AlphaCassiopeiae/8800/rs/README.md

# αCass 8800 Software
## Firmware
* `cycle`: emulated CPU card
* `recall`: emulated memory card
* `interchange`: emulated front panel device
* `ubahn`: emulated UART I/O card (not active)
* `tramtest`: minimal tram testing/debugging 
## Libraries
* `common`: utilities
* `runner`: CPU emulation core
* `tram`: low-level bus interface
