AlphaCassiopeiae/8800/docs/poster2.pdf

CPU

GND

SWDIO

SWCLK

GND

USBD-

USBD+

3V3

VBUS

SS

SD
4:0

SCLK

XIN

XOUT

~RESET

15:0
7:0

RP2350B...

ABM8-272-T3...

Chip Reset Ci...

W25Q128JVS... | SWD Debug Port

USB-C Debug P...

USB Debug Reg...

DDR4 DIMM Edge Connector ³V³ GND CLOCK PRESET PANEL PROT SM¹ SHLTA SSTACK | PHOLD | PDBIN | SWO | PWAIT | PRDY
SOUT
SINP

XRDY

MWRT

SMEMR
PINT

SINTA

PINTE
ADDR
DATA

Front Panel

Molex 5017868090 FFC Receptacle

RP2350B...

7:0

15:0

CLOCK

PRESET

PANEL
PROT
SM1

SHLTA
SSTACK

PHOLD
PDBIN

SWO

PWAIT

PRDY

SOUT
SINP

XRDY

MWRT
SMEMR

PINT

SINTA
PINTE
ADDR

GND

DATA
3V3

LED Array

D7 D6 D5 D4 D3 D2 D1 D0

A15 A14 A13 A12 A11 A10 A9 A8 A7 A6 A5 A4 A3 A2 A1 A0

DATA07 | DATA06 | DATA05 | DATA04 | DATA03 | DATA02 | DATA01 | DATA00
ADDR15 | ADDR14 | ADDR13 | ADDR12 | ADDR11 | ADDR10 | ADDR09 | ADDR08 | ADDR07 | ADDR06 | ADDR05 | ADDR04 | ADDR03 | ADDR02 | ADDR01 | ADDR00
INTE
PROT
MEMR
INP
M1
OUT
HLTA
STACK
WO
INT
WAIT
HLDA

TLC59211IPWR

TLC59211IPWR

Current Driven

TLC59211IPWR
GND

3V3

GND

3V3

GND

3V3

Power...

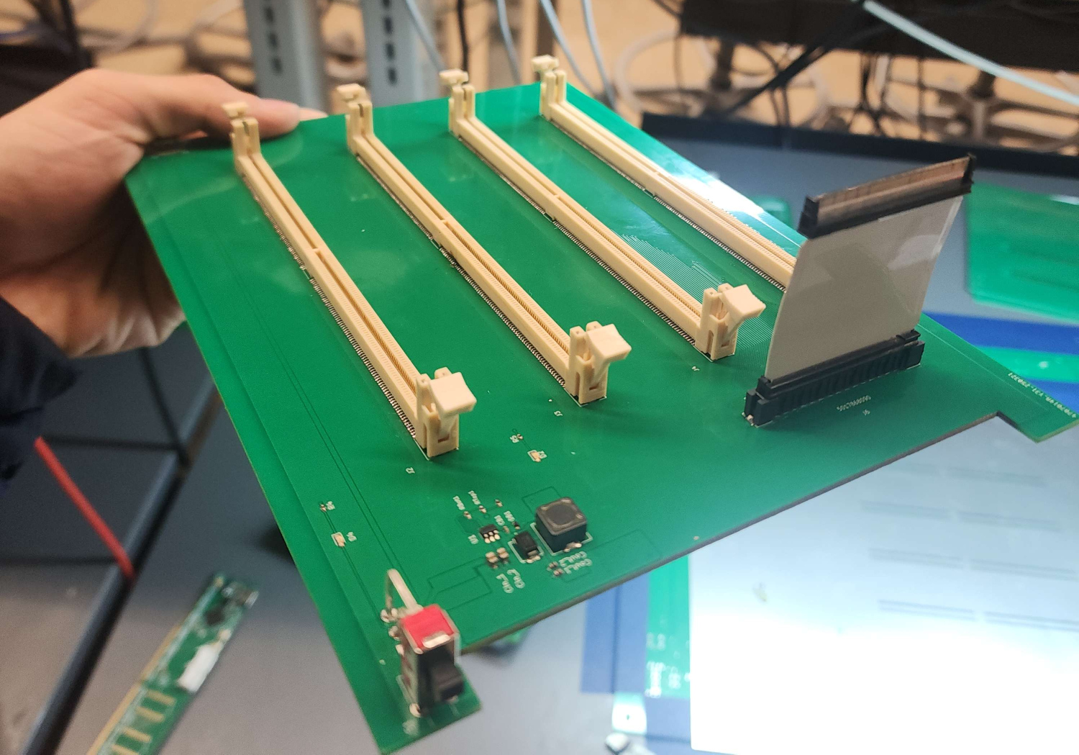
[picture p8: figure]

SS

SD
4:0

SCLK

XIN

XOUT

ABM8-272-T3...

Chip Reset Ci...

W25Q128JVS...

GND

SWDIO

SWCLK
SWD Debug Port

GND

USBD-

USBD+

3V3

VBUS

USB-C Debug P...

USB Debug Reg...

MCP23017 I2C...

MCP23017 I2C...

~RESET

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
Switch/Button Array

SW15 | SW14 | SW13 | SW12 | SW11 | SW10 | SW09 | SW08
SW07 | SW06 | SW05 | SW04 | SW03 | SW02 | SW01 | SW00
AUX2 | AUX1 UPROT PROT | CLR
RESET DEPN | DEP | EXMN | EXM | SS | RUN | STOP
GPB7 | GPB6 | GPB5 | GPB4 | GPB3 | GPB2 | GPB1 | GPB0
GPA7 | GPA6 | GPA5 | GPA4 | GPA3 | GPA2 | GPA1 | GPA0
GPB4 | GPB3 | GPB2 | GPB1 | GPB0
GPA7 | GPA6 | GPA5 | GPA4 | GPA3 | GPA2 | GPA1 | GPA0

DDR4 DIMM Slot Receptacle

Backplane

RAM

GND

SWDIO

SWCLK

GND

USBD-

USBD+

3V3

VBUS

SS

SD
4:0

SCLK

XIN

XOUT

~RESET

15:0
7:0

RP2350B...

ABM8-272-T3...

Chip Reset Ci...

W25Q128JVS... | SWD Debug Port

USB-C Debug P...

USB Debug Reg...

DDR4 DIMM Edge Connector ³V³ GND CLOCK PRESET PANEL PROT SM¹ SHLTA SSTACK | PHOLD | PDBIN | SWO | PWAIT | PRDY
SOUT
SINP

XRDY

MWRT

SMEMR
PINT

SINTA

PINTE
ADDR
DATA

Backplane

Molex 5017868090 FFC Receptacle

Voltage Re... USB-C...

DDR4 DIMM Slot Receptacle | VBUS
3V3

80-conductor 0.5mm Pitch FFC Cable

# BLOCK DIAGRAM

Legend

Card PCB

Backplane P...

Front Panel...

UI Element

# BUS DESIGN

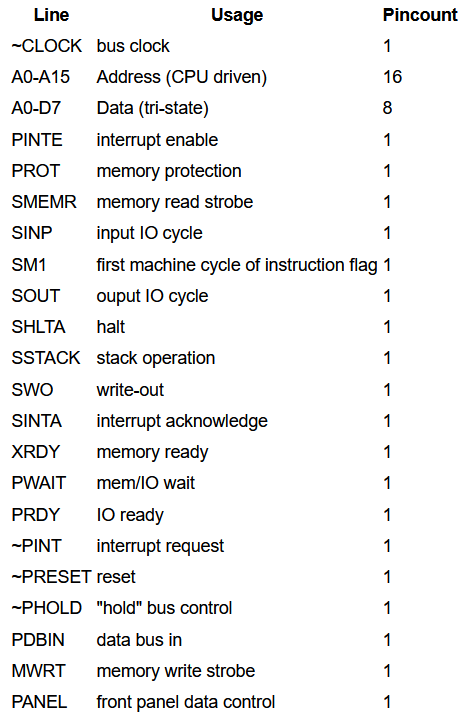
[picture p9: figure]

# EMULATION

# COMPONENTS

# PANEL

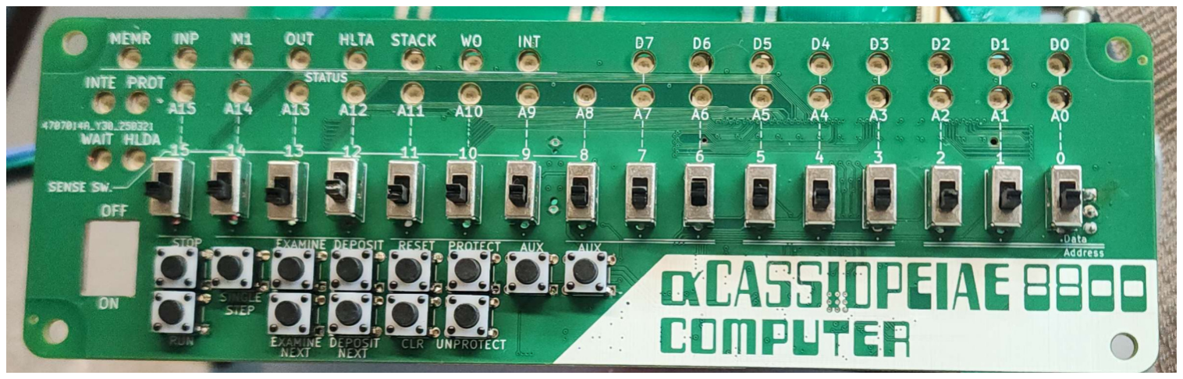
[picture p10: figure]

# CARDS

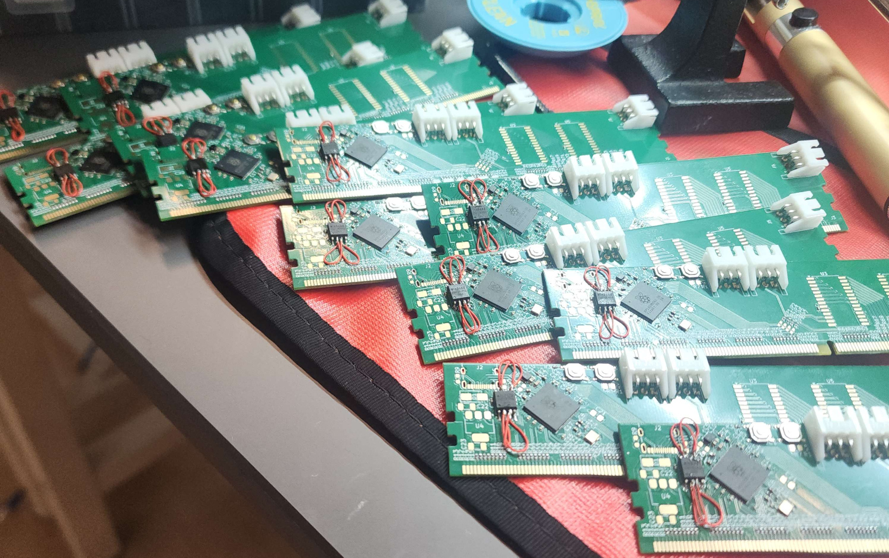
[picture p11: figure]

# BACKPLANE

At the heart of the αCassiopeiae 8800 lies sophisticated software enabling its functionality. A key component is the custom-built Intel 8080 CPU emulator, developed in Rust. This emulator achieves high fidelity, accurately decoding and executing 254 out of the 256 official 8080 opcodes. It meticulously replicates the 8080's machine cycles, including managing cycle timing, interrupt handling, and respecting I/O wait states, crucial for authentic operation. Complementing the emulator are low-level routines leveraging the Raspberry Pi RP2350B's powerful Programmable I/O (PIO) feature. Written in PIO assembly, these routines manage the intricate data exchange across the system's parallel bus. They orchestrate the complex transactions required for communication between the emulated CPU, the RAM card, and the interactive Front Panel, ensuring correct multi-device access and control over the shared bus lines for memory reads/writes, I/O operations, and front panel interactions.
