AlphaCassiopeiae/8800/docs/panel_pins.md

| Pin | Old | New | RP2350 | Driver |
|---|---|---|---|---|
| BUS03 | ~~???~~ | A3 | GPIO35 | U5 9 |
| BUS04 | ~~???~~ | D3 | GPIO34 | U5 8 |
| BUS05 | ~~???~~ | A2 | GPIO33 | U5 7 |
| BUS06 | ~~???~~ | D2 | GPIO32 | U5 6 |
| BUS09 | ~~???~~ | A0 | GPIO31 | U5 5 |
| BUS10 | ~~???~~ | A1 | GPIO41 | U5 4 |
| BUS11 | ~~???~~ | D1 | GPIO30 | U5 3 |
| BUS12 | ~~???~~ | D0 | GPIO40 | U5 2 |
| BUS15 | ~~???~~ | | | |
| BUS16 | ~~A0~~ | | | |
| BUS17 | ~~A1~~ | | | |
| BUS18 | ~~A2~~ | | | |
| BUS21 | ~~A3~~ | PANEL  | GPIO29 | |
| BUS22 | ~~A4~~ | MWRT | GPIO46 | |
| BUS23 | ~~A5~~ | DBIN | GPIO47 | |
| BUS24 | ~~A6~~ | HOLD | GPIO28 | |
| BUS27 | ~~A7~~ | RESET  | GPIO27 | |
| BUS28 | ~~D0~~ | PRDY | GPIO26 | |
| BUS29 | ~~D1~~ | XRDY | GPIO25 | |
| BUS30 | ~~D2~~ | INTA | GPIO24 | |
| BUS33 | ~~D3~~ | D7 | GPIO23 | U4 9 |
| BUS34 | ~~D4~~ | D6 | GPIO21 | U4 8 |
| BUS35 | ~~D5~~ | A6 | GPIO22 | U4 7 |
| BUS36 | ~~D6~~ | A7 | GPIO20 | U4 6 |
| BUS44 | ~~A8~~ | D5 | GPIO19 | U4 5 |
| BUS45 | ~~A9~~ | A5 | GPIO18 | U4 4 |
| BUS46 | ~~A10~~ | D4 | GPIO17 | U4 3 |
| BUS47 | ~~A11~~ | A4 | GPIO16 | U4 2 |
| BUS50 | ~~A12~~ | PROT | GPIO15 | U1 6 |
| BUS51 | ~~A13~~ | INTE | GPIO14 | U1 7 |
| BUS52 | ~~A14~~ | WAIT | GPIO13 | U1 8 |
| BUS53 | ~~A15~~ | HLDA | GPIO11 | U1 9 |
| BUS56 | ~~INT~~ | A12 | GPIO12 | U2 2 |
| BUS57 | ~~WO~~ | A13 | GPIO10 | U2 3 |
| BUS58 | ~~STACK~~ | OUT | GPIO09 | U2 4 |
| BUS59 | ~~HLTA~~ | M1 | GPIO08 | U2 5 |
| BUS62 | ~~OUT~~ | A14 | GPIO07 | U2 6 |
| BUS63 | ~~M1~~ | MEMR | GPIO06 | U2 7 |
| BUS64 | ~~INP~~ | INP | GPIO05 | U2 8 |
| BUS65 | ~~MEMR~~ | A15 | GPIO04 | U2 9 |
| BUS68 | ~~HLDA~~ | HLTA | GPIO00 | U3 9 |
| BUS69 | ~~WAIT~~ | STACK  | GPIO01 | U3 8 |
| BUS70 | ~~PROT~~ | A11 | GPIO03 | U3 7 |
| BUS71 | ~~INTE~~ | WO | GPIO02 | U3 6 |
| BUS74 | ~~I2C1_SCK~~ | A10 | GPIO45 | U3 5 |
| BUS75 | ~~I2C1_SDA~~ | INT | GPIO44 | U3 4 |
| BUS76 | ~~I2C0_SCK~~ | A9 | GPIO43 | U3 3 |
| BUS77 | ~~I2C0_SDA~~ | A8 | GPIO42 | U3 2 |
