AlphaCassiopeiae/8800/ecad/panel/#Laser.dxf

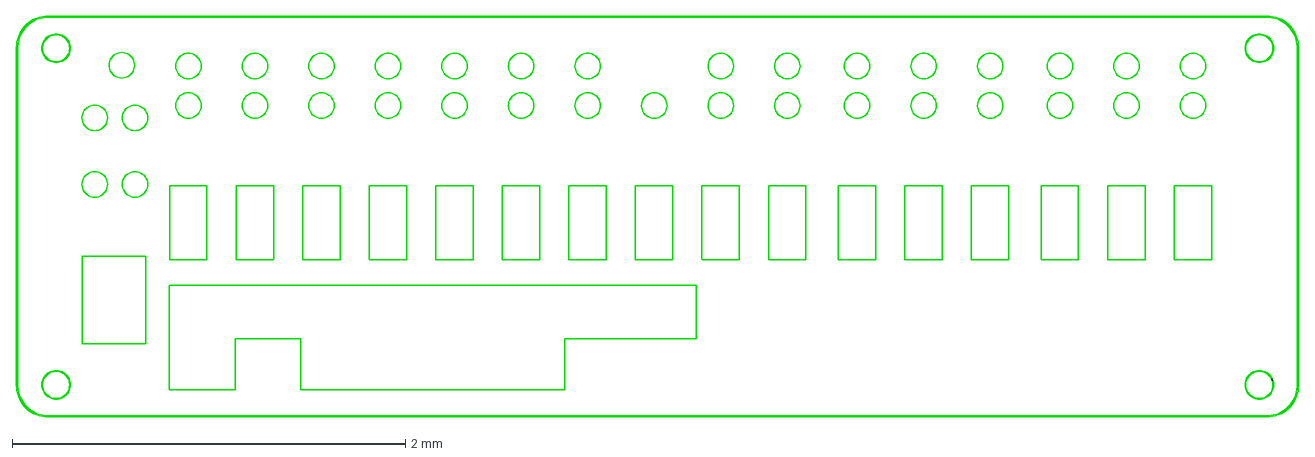
[picture p12: CAD file, 2025-04-22]
ecad/panel/#Laser.dxf
6.52 x 2.04 mm
