AlphaCassiopeiae/8800/mcad/Back Bezel Cutout.step

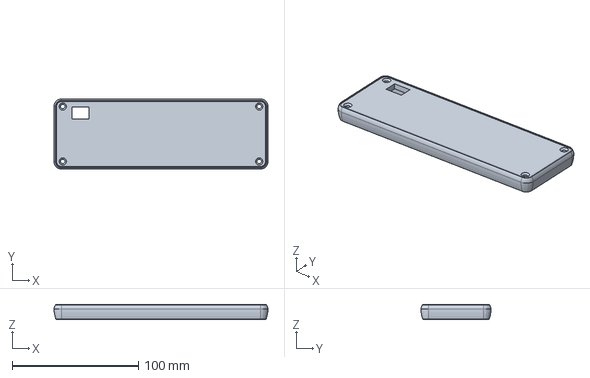
[picture p13: CAD file, 2025-04-30]
mcad/Back Bezel Cutout.step
169.5 x 55.6 x 11.5 mm
