AlphaCassiopeiae/8800/mcad/Front Bezel Cutout.step

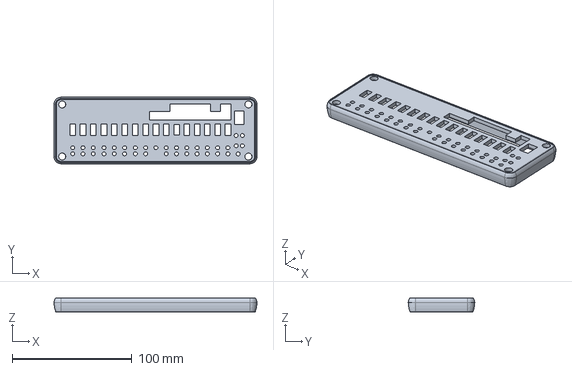
[picture p14: CAD file, 2025-04-30]
mcad/Front Bezel Cutout.step
169.5 x 55.6 x 11.5 mm
