AlphaCassiopeiae/8800/ecad/panel/panel-User_9.dxf

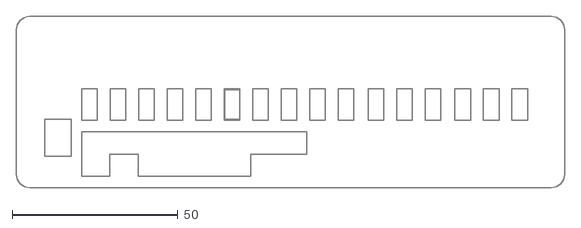
[picture p15: CAD file, 2025-04-22]
ecad/panel/panel-User_9.dxf
165.5 x 51.6
