AlphaCassiopeiae/8800/mcad/8800.FCStd

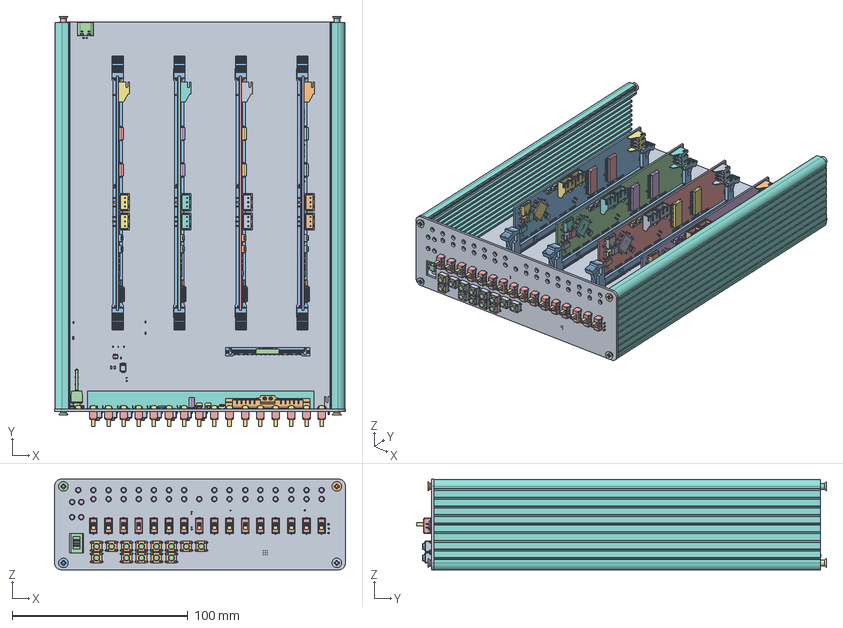
[picture p16: CAD file, 2025-04-30]
mcad/8800.FCStd
165.5 x 233.2 x 51.7 mm
Pcb_eb7f
OS102011MS2QN1 x 16
OS102011MS2QN002 x 16
OS102011MS2QN003 x 16
OS102011MS2QN004 x 16
OS102011MS2QN005 x 16
OS102011MS2QN006 x 16
R30_R_0402_1005Metric_0d118fe001ea x 90
AA3528-09 x 36
AA3528-010 x 36
AA3528-011 x 36
AA3528-012 x 36
AA3528-013 x 36
AA3528-014 x 36
D37_LED_0603_1608Metric_4a49271d0e42
U2_Texas_PWP0020A_8a7b458e77f9 x 5
LSM115JE3_TR13 x 3
LSM115JE3_TR014 x 3
LSM115JE3_TR015 x 3
LSM115JE3_TR016 x 3
C17_C_0402_1005Metric_134aba42bafa x 29
J2_JST_B3B_XH_A_700a59d3412c
5017868090wbm000_01
5017868090wbm000_002
U7_SOIC_8_5275x5275mm_P127mm_7bc3da358a65
U10_SOT_223_ac2cde4d368e
U9_QFN-28-1EP_6x6mm_Pitch0.65mm_3e3c0530614f x 2
Frame x 2
Cover x 2
Stem x 2
Terminal x 2
Terminal001 x 2
Terminal002 x 2
Terminal003 x 2
U6_rp2350text_0fa20b81210b
L1_AOTA-B201610S3R3-101-T_75ad346b99e7
T extrusion 220mm
1455 screw
1455 screw001
1455 screw002
1455 screw003
1455 screw004
1455 screw005
1455 screw006
1455 screw007
Pcb_b010
USB4105GFA_USB4105GFA
USB4105GFA_USB4105GFA001
USB4105GFA_USB4105GFA002
USB4105GFA_USB4105GFA003
USB4105GFA_USB4105GFA004
USB4105GFA_USB4105GFA005
USB4105GFA_USB4105GFA006
USB4105GFA_USB4105GFA007
USB4105GFA_USB4105GFA008
USB4105GFA_USB4105GFA009
USB4105GFA_USB4105GFA010
USB4105GFA_USB4105GFA011
USB4105GFA_USB4105GFA012
USB4105GFA_USB4105GFA013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
