AlphaCassiopeiae/8800/ecad/panel/Silkscreen.dxf

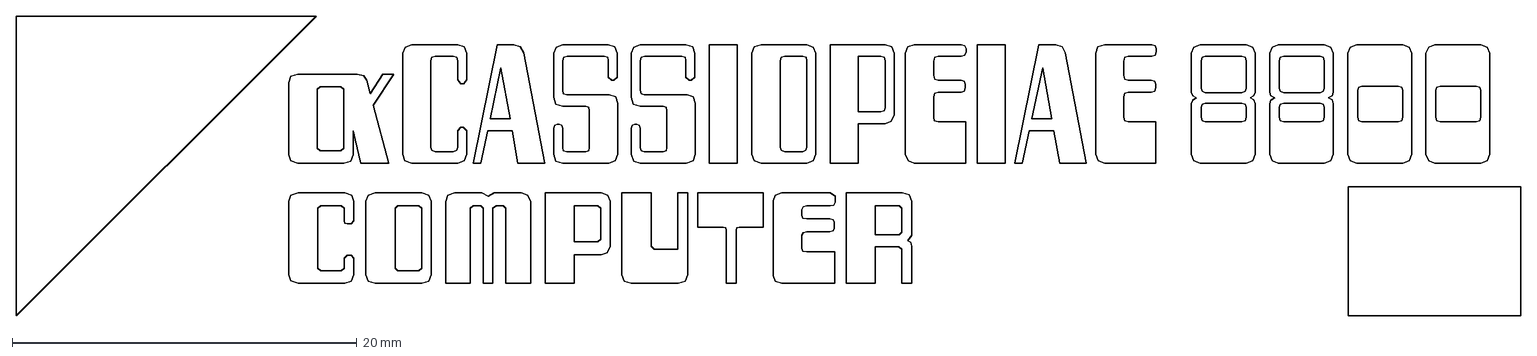
[picture p17: CAD file, 2025-03-16]
ecad/panel/Silkscreen.dxf
87.2 x 17.4 mm
