AlphaCassiopeiae/8800/mcad/Back Bezel.dxf

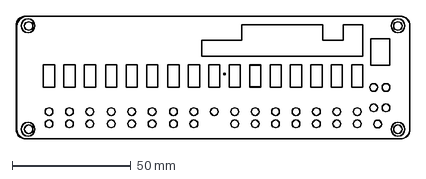
[picture p18: CAD file, 2025-04-22]
mcad/Back Bezel.dxf
165.5 x 51.7 mm
