AlphaCassiopeiae/8800/mcad/Laser_Cutout.FCStd

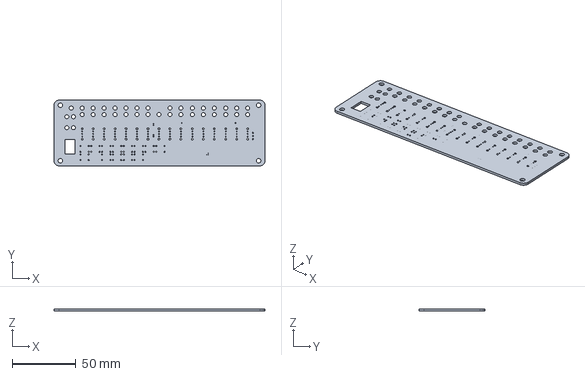
[picture p19: CAD file, 2025-04-22]
mcad/Laser_Cutout.FCStd
165.5 x 51.6 x 1.60 mm
