AlphaCassiopeiae/8800/mcad/Front Bezel.dxf

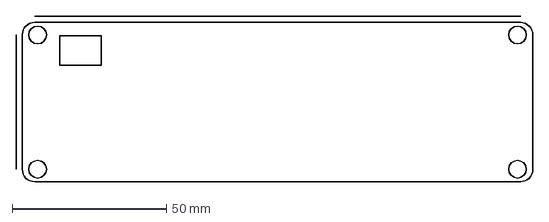
[picture p20: CAD file, 2025-04-22]
mcad/Front Bezel.dxf
167.5 x 53.6 mm
