AlphaCassiopeiae/8800/mcad/1455T2201.stp

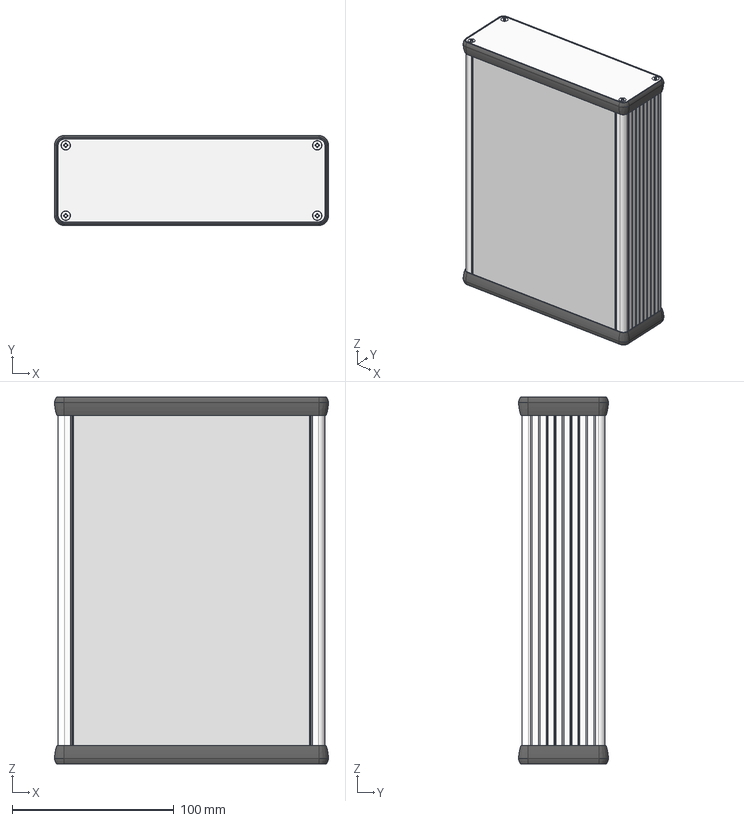
[picture p21: CAD file, 2025-03-12]
mcad/1455T2201.stp
169.5 x 55.6 x 227.0 mm
T extrusion 220mm
T Extrusion Cap 220mm
T Bezel Open x 2
T End Plate x 2
1455 screw x 8
