AlphaCassiopeiae/8800/(list of files, cad)

Other CAD files:
ecad/panel/Laser This.dxf
mcad/Black Bezel.dwg
mcad/Blue Bezel.dwg
ecad/panel/Laser.dxf
mcad/Back Bezel.f3d
mcad/Black Bezel Fusion.f3z
mcad/Blue Bezel Fusion.f3z
mcad/Front Bezel.f3d
