AlphaCassiopeiae/8800/ecad/panel/panel.kicad_pcb

## KiCad design ecad/panel/panel.kicad_pcb (2025-04-22)

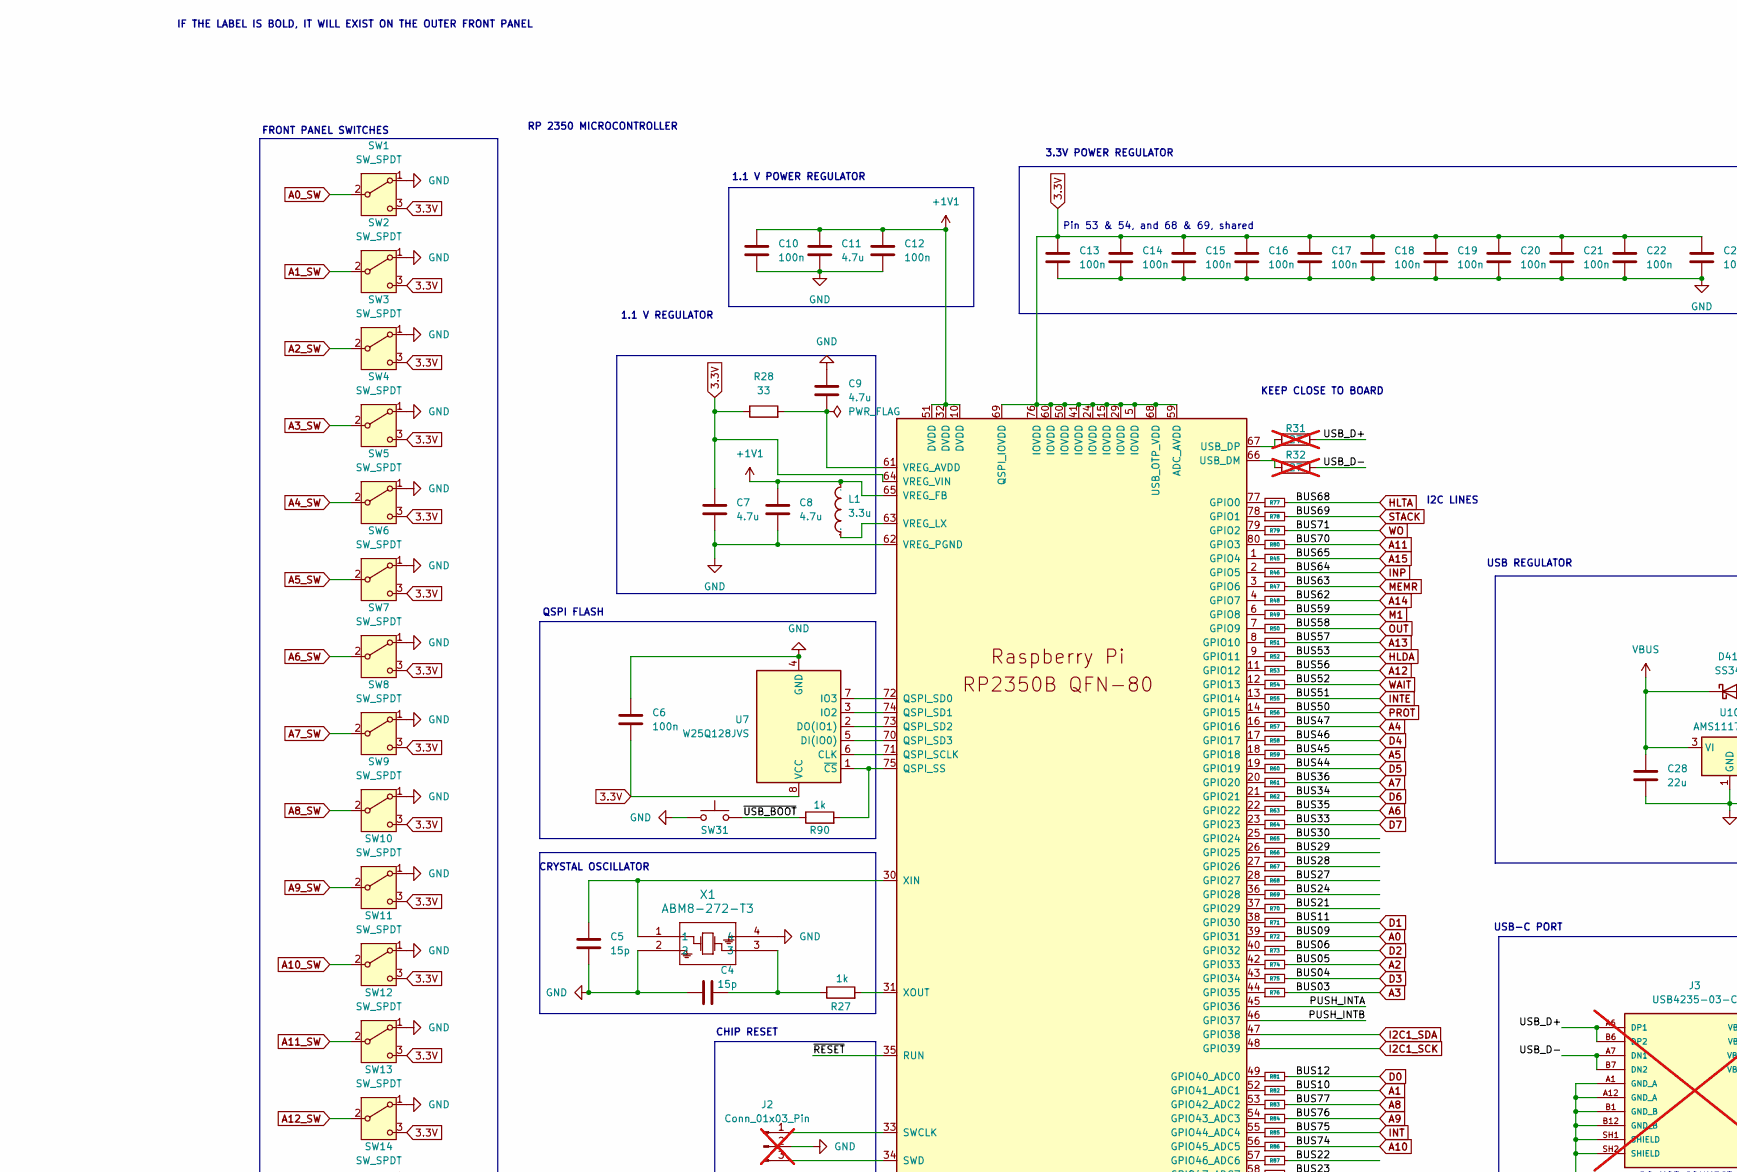
[picture p22: schematic panel.kicad_sch, Front Panel, part in row 1, column 2]

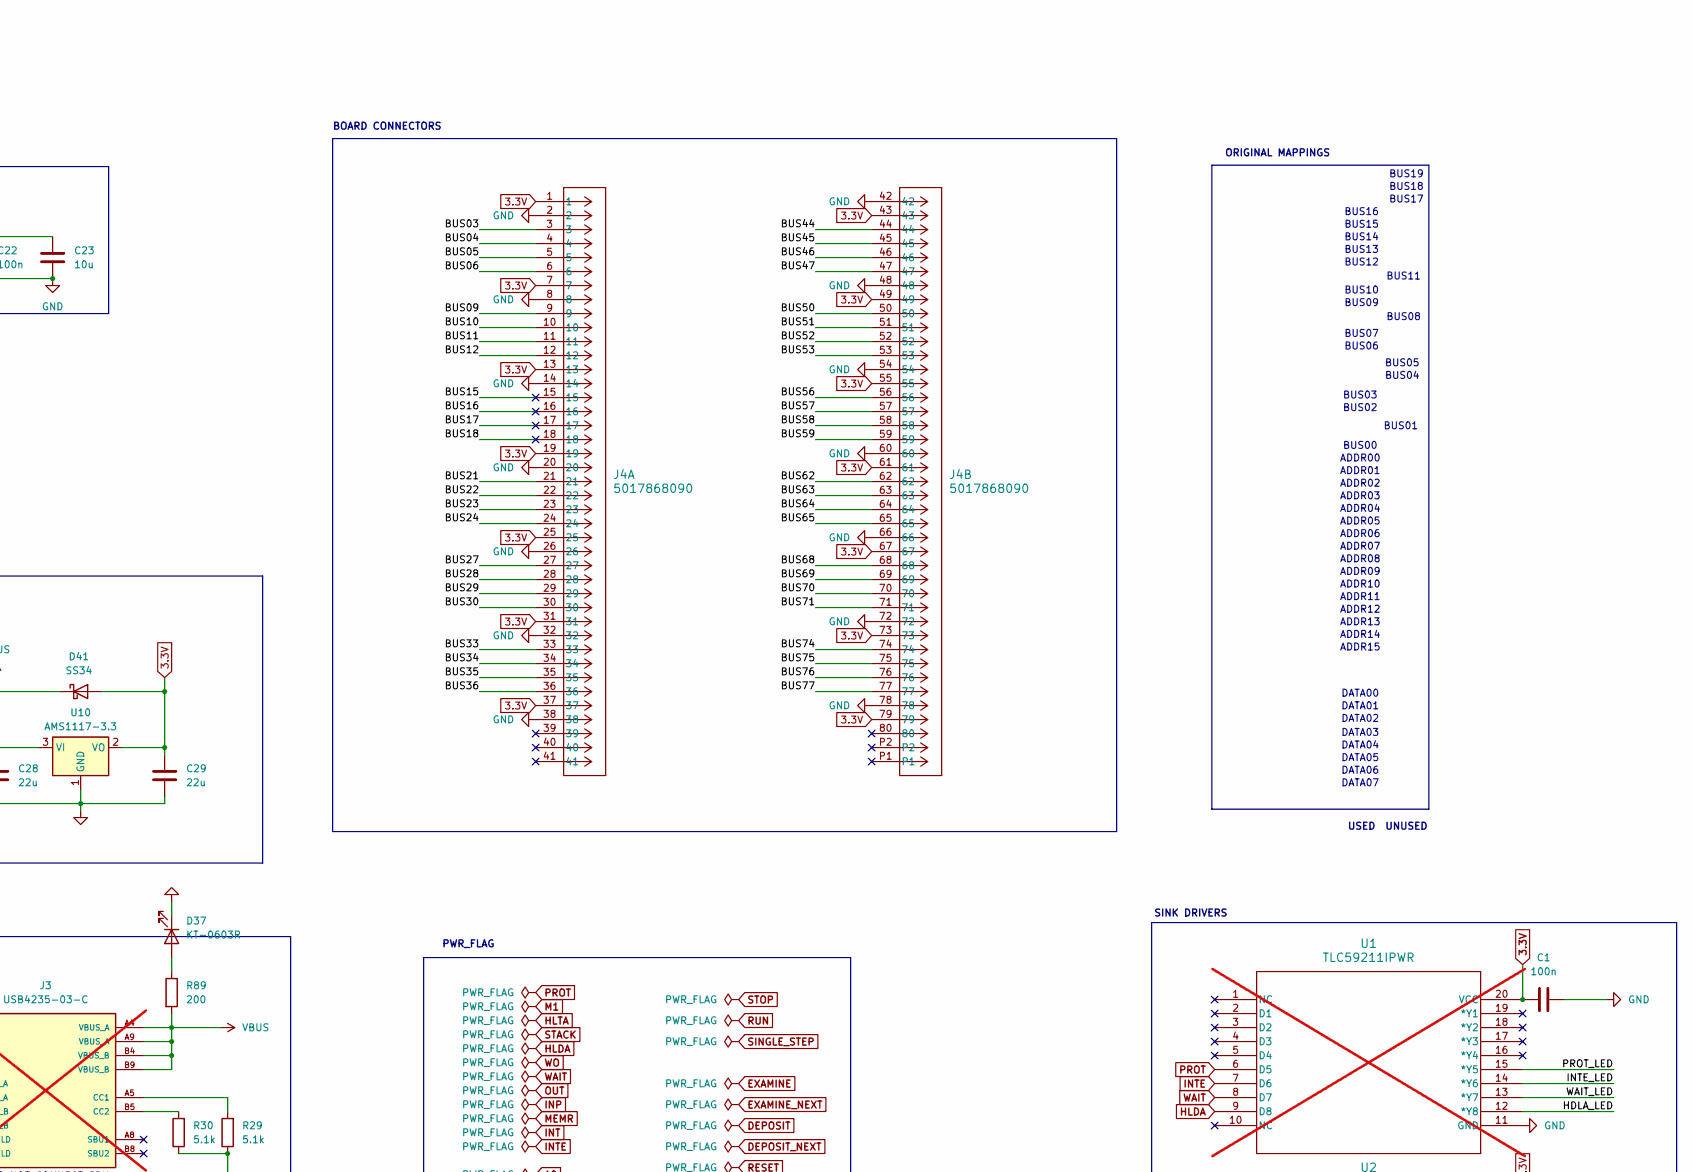
[picture p23: schematic panel.kicad_sch, Front Panel, part in row 1, column 3]

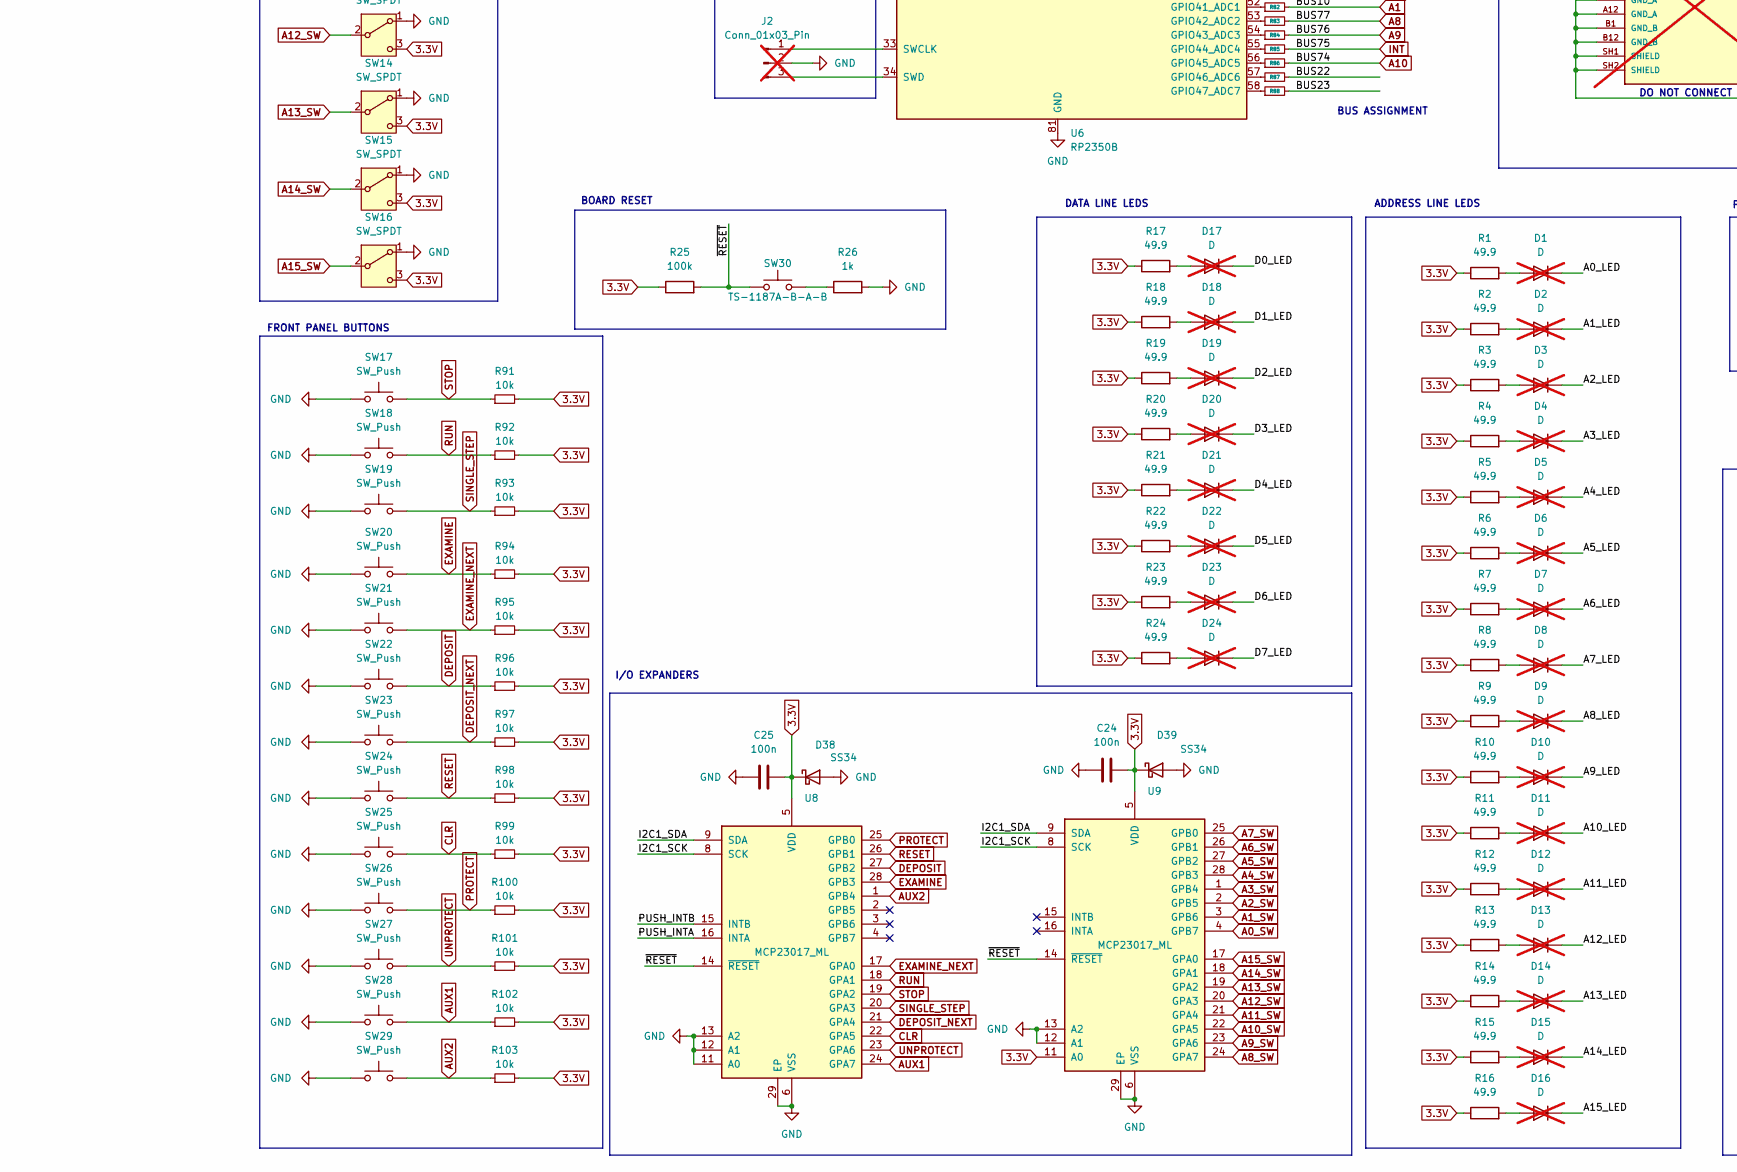
[picture p24: schematic panel.kicad_sch, Front Panel, part in row 2, column 2]

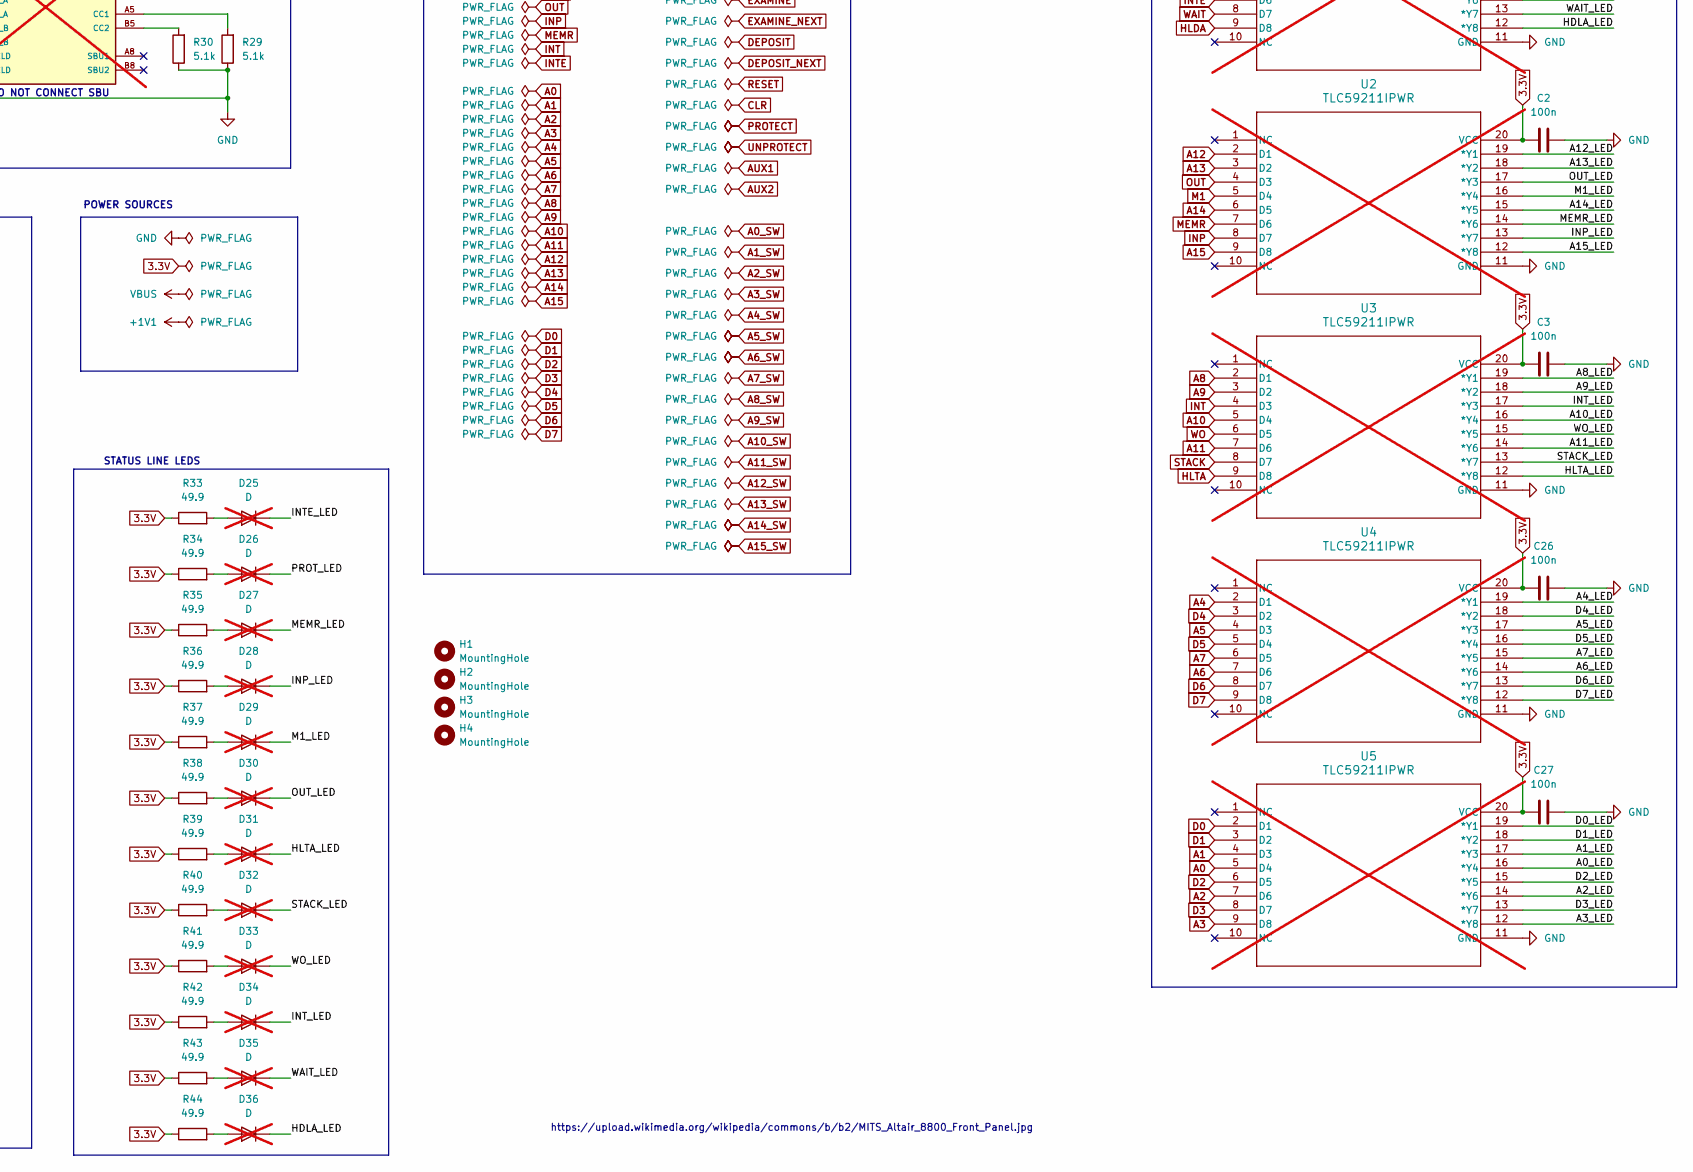
[picture p25: schematic panel.kicad_sch, Front Panel, part in row 2, column 3]

Parts:
C1, C2, C3, C6, C10, C12, C13, C14, C15, C16, C17, C18, C19, C20, C21, C22, C24, C25, C26, C27: 100n; C_0402_1005Metric
C4, C5: 15p; C_0402_1005Metric
C7, C8, C9, C11: 4.7u; C_0402_1005Metric
C23: 10u; C_0402_1005Metric
C28, C29: 22u; C_1206_3216Metric
D1, D2, D3, D4, D5, D6, D7, D8, D9, D10, D11, D12, D13, D14, D15, D16, D17, D18, D19, D20, D21, D22, D23, D24, D25, D26, D27, D28, D29, D30, D31, D32, D33, D34, D35, D36: D; AA3528SECKTJ309; not fitted
D37: KT-0603R; LED_0603_1608Metric_Pad1.05x0.95mm_HandSolder; LCSC Part # C2286
D38, D39, D41: SS34; D_SMA
H1, H2, H3, H4: MountingHole; MountingHole_3.5mm
J2: Conn_01x03_Pin; JST_XH_B3B-XH-A_1x03_P2.50mm_Vertical; not fitted
J3: USB4235-03-C; GCT_USB4235-03-C_REVA; PARTREV A; not fitted
J4: 5017868090; CON_5017868090
L1: 3.3u; IND-SMD_L2.0-W1.6_AOTA-B201610S3R3-101-T; Manufacturer Part AOTA-B201610S3R3-101-T; LCSC Part # C42411119
R1, R2, R3, R4, R5, R6, R7, R8, R9, R10, R11, R12, R13, R14, R15, R16, R17, R18, R19, R20, R21, R22, R23, R24, R33, R34, R35, R36, R37, R38, R39, R40, R41, R42, R43, R44: 49.9; R_0402_1005Metric_Pad0.72x0.64mm_HandSolder
R25: 100k; R_0402_1005Metric_Pad0.72x0.64mm_HandSolder
R26, R27, R90: 1k; R_0402_1005Metric_Pad0.72x0.64mm_HandSolder
R28: 33; R_0402_1005Metric_Pad0.72x0.64mm_HandSolder
R29, R30: 5.1k; R_0402_1005Metric_Pad0.72x0.64mm_HandSolder
R31, R32: 27; R_0603_1608Metric_Pad0.98x0.95mm_HandSolder; not fitted
R45, R46, R47, R48, R49, R50, R51, R52, R53, R54, R55, R56, R57, R58, R59, R60, R61, R62, R63, R64, R65, R66, R67, R68, R69, R70, R71, R72, R73, R74, R75, R76, R77, R78, R79, R80, R81, R82, R83, R84, R85, R86, R87, R88: 330; R_0402_1005Metric_Pad0.72x0.64mm_HandSolder
R89: 200; R_0402_1005Metric_Pad0.72x0.64mm_HandSolder
R91, R92, R93, R94, R95, R96, R97, R98, R99, R100, R101, R102, R103: 10k; C_0402_1005Metric
SW1, SW2, SW3, SW4, SW5, SW6, SW7, SW8, SW9, SW10, SW11, SW12, SW13, SW14, SW15, SW16: SW_SPDT; SW_OS102011MS2QN1
SW17, SW18, SW19, SW20, SW21, SW22, SW23, SW24, SW25, SW26, SW27, SW28, SW29: SW_Push; SW_1825910-6-4
SW30, SW31: TS-1187A-B-A-B; SW_Push_1P1T_XKB_TS-1187A
U1, U2, U3, U4, U5: TLC59211IPWR; Texas_PWP0020A; not fitted
U6: RP2350B; RP2350-QFN-80-1EP_10x10_P0.4mm_EP3.4x3.4mm_ThermalVias
U7: W25Q128JVS; SOIC-8_5.23x5.23mm_P1.27mm
U8, U9: MCP23017_ML; QFN-28-1EP_6x6mm_P0.65mm_EP4.25x4.25mm; LCSC Part # C639770
U10: AMS1117-3.3; SOT-223-3_TabPin2
X1: ABM8-272-T3; ABM8-272-T3_ABR

Connections:
3.3V: C1.1, C2.1, C3.1, C6.1, C7.1, C13.1, C14.1, C15.1, C16.1, C17.1, C18.1, C19.1, C20.1, C21.1, C22.1, C23.1, C24.2, C25.2, C26.1, C27.1, C29.1, D38.1 (K), D39.1 (K), D41.2 (A), J4.1, J4.7, J4.13, J4.19, J4.25, J4.31, J4.37, J4.43, J4.49, J4.55, J4.61, J4.67, J4.73, J4.79, R1.1, R2.1, R3.1, R4.1, R5.1, R6.1, R7.1, R8.1, R9.1, R10.1, R11.1, R12.1, R13.1, R14.1, R15.1, R16.1, R17.1, R18.1, R19.1, R20.1, R21.1, R22.1, R23.1, R24.1, R25.1, R28.1, R33.1, R34.1, R35.1, R36.1, R37.1, R38.1, R39.1, R40.1, R41.1, R42.1, R43.1, R44.1, R91.2, R92.2, R93.2, R94.2, R95.2, R96.2, R97.2, R98.2, R99.2, R100.2, R101.2, R102.2, R103.2, SW1.3 (C), SW2.3 (C), SW3.3 (C), SW4.3 (C), SW5.3 (C), SW6.3 (C), SW7.3 (C), SW8.3 (C), SW9.3 (C), SW10.3 (C), SW11.3 (C), SW12.3 (C), SW13.3 (C), SW14.3 (C), SW15.3 (C), SW16.3 (C), U1.20 (VCC), U2.20 (VCC), U3.20 (VCC), U4.20 (VCC), U5.20 (VCC), U6.5 (IOVDD), U6.15 (IOVDD), U6.24 (IOVDD), U6.29 (IOVDD), U6.41 (IOVDD), U6.50 (IOVDD), U6.59 (ADC_AVDD), U6.60 (IOVDD), U6.64 (VREG_VIN), U6.68 (USB_OTP_VDD), U6.69 (QSPI_IOVDD), U6.76 (IOVDD), U7.8 (VCC), U8.5 (VDD), U9.5 (VDD), U9.11 (A0), U10.2 (VO)
+1V1: C8.1, C10.1, C11.1, C12.1, L1.2, U6.10 (DVDD), U6.32 (DVDD), U6.51 (DVDD), U6.65 (VREG_FB)
/A0_LED: D1.1 (K), U5.16 (*Y4)
/A1_LED: D2.1 (K), U5.17 (*Y3)
/A2_LED: D3.1 (K), U5.14 (*Y6)
/A3_LED: D4.1 (K), U5.12 (*Y8)
/A4_LED: D5.1 (K), U4.19 (*Y1)
/A5_LED: D6.1 (K), U4.17 (*Y3)
/A6_LED: D7.1 (K), U4.14 (*Y6)
/A7_LED: D8.1 (K), U4.15 (*Y5)
/A8_LED: D9.1 (K), U3.19 (*Y1)
/A9_LED: D10.1 (K), U3.18 (*Y2)
/A10_LED: D11.1 (K), U3.16 (*Y4)
/A11_LED: D12.1 (K), U3.14 (*Y6)
/A12_LED: D13.1 (K), U2.19 (*Y1)
/A13_LED: D14.1 (K), U2.18 (*Y2)
/A14_LED: D15.1 (K), U2.15 (*Y5)
/A15_LED: D16.1 (K), U2.12 (*Y8)
/BUS15: J4.15
/BUS16: J4.16
/BUS17: J4.17
/BUS18: J4.18
/BUS21: J4.21, R70.2
/BUS22: J4.22, R87.2
/BUS23: J4.23, R88.2
/BUS24: J4.24, R69.2
/BUS27: J4.27, R68.2
/BUS28: J4.28, R67.2
/BUS29: J4.29, R66.2
/BUS30: J4.30, R65.2
/D0_LED: D17.1 (K), U5.19 (*Y1)
/D1_LED: D18.1 (K), U5.18 (*Y2)
/D2_LED: D19.1 (K), U5.15 (*Y5)
/D3_LED: D20.1 (K), U5.13 (*Y7)
/D4_LED: D21.1 (K), U4.18 (*Y2)
/D5_LED: D22.1 (K), U4.16 (*Y4)
/D6_LED: D23.1 (K), U4.13 (*Y7)
/D7_LED: D24.1 (K), U4.12 (*Y8)
/HDLA_LED: D36.1 (K), U1.12 (*Y8)
/HLTA_LED: D31.1 (K), U3.12 (*Y8)
/INP_LED: D28.1 (K), U2.13 (*Y7)
/INTE_LED: D25.1 (K), U1.14 (*Y6)
/INT_LED: D34.1 (K), U3.17 (*Y3)
/M1_LED: D29.1 (K), U2.16 (*Y4)
/MEMR_LED: D27.1 (K), U2.14 (*Y6)
/OUT_LED: D30.1 (K), U2.17 (*Y3)
/PROT_LED: D26.1 (K), U1.15 (*Y5)
/PUSH_INTA: U6.45 (GPIO36), U8.16 (INTA)
/PUSH_INTB: U6.46 (GPIO37), U8.15 (INTB)
/STACK_LED: D32.1 (K), U3.13 (*Y7)
/USB_D+: J3.A6 (DP1), J3.B6 (DP2), R31.2
/USB_D-: J3.A7 (DN1), J3.B7 (DN2), R32.2
/WAIT_LED: D35.1 (K), U1.13 (*Y7)
/WO_LED: D33.1 (K), U3.15 (*Y5)
/~RESET: R25.2, SW30.1, U6.35 (RUN), U8.14 (~RESET), U9.14 (~RESET)
/~USB_BOOT: R90.1, SW31.2
A0: J4.9, R72.2, U5.5 (D4)
A0_SW: SW1.2 (B), U9.4 (GPB7)
A1: J4.10, R82.2, U5.4 (D3)
A1_SW: SW2.2 (B), U9.3 (GPB6)
A2: J4.5, R74.2, U5.7 (D6)
A2_SW: SW3.2 (B), U9.2 (GPB5)
A3: J4.3, R76.2, U5.9 (D8)
A3_SW: SW4.2 (B), U9.1 (GPB4)
A4: J4.47, R57.2, U4.2 (D1)
A4_SW: SW5.2 (B), U9.28 (GPB3)
A5: J4.45, R59.2, U4.4 (D3)
A5_SW: SW6.2 (B), U9.27 (GPB2)
A6: J4.35, R63.2, U4.7 (D6)
A6_SW: SW7.2 (B), U9.26 (GPB1)
A7: J4.36, R61.2, U4.6 (D5)
A7_SW: SW8.2 (B), U9.25 (GPB0)
A8: J4.77, R83.2, U3.2 (D1)
A8_SW: SW9.2 (B), U9.24 (GPA7)
A9: J4.76, R84.2, U3.3 (D2)
A9_SW: SW10.2 (B), U9.23 (GPA6)
A10: J4.74, R86.2, U3.5 (D4)
A10_SW: SW11.2 (B), U9.22 (GPA5)
A11: J4.70, R80.2, U3.7 (D6)
A11_SW: SW12.2 (B), U9.21 (GPA4)
A12: J4.56, R53.2, U2.2 (D1)
A12_SW: SW13.2 (B), U9.20 (GPA3)
A13: J4.57, R51.2, U2.3 (D2)
A13_SW: SW14.2 (B), U9.19 (GPA2)
A14: J4.62, R48.2, U2.6 (D5)
A14_SW: SW15.2 (B), U9.18 (GPA1)
A15: J4.65, R45.2, U2.9 (D8)
A15_SW: SW16.2 (B), U9.17 (GPA0)
AUX1: R102.1, SW28.2, U8.24 (GPA7)
AUX2: R103.1, SW29.2, U8.1 (GPB4)
CLR: R99.1, SW25.2, U8.22 (GPA5)
D0: J4.12, R81.2, U5.2 (D1)
D1: J4.11, R71.2, U5.3 (D2)
D2: J4.6, R73.2, U5.6 (D5)
D3: J4.4, R75.2, U5.8 (D7)
D4: J4.46, R58.2, U4.3 (D2)
D5: J4.44, R60.2, U4.5 (D4)
D6: J4.34, R62.2, U4.8 (D7)
D7: J4.33, R64.2, U4.9 (D8)
DEPOSIT: R96.1, SW22.2, U8.27 (GPB2)
DEPOSIT_NEXT: R97.1, SW23.2, U8.21 (GPA4)
EXAMINE: R94.1, SW20.2, U8.28 (GPB3)
EXAMINE_NEXT: R95.1, SW21.2, U8.17 (GPA0)
GND: C1.2, C2.2, C3.2, C4.2, C5.2, C6.2, C7.2, C8.2, C9.1, C10.2, C11.2, C12.2, C13.2, C14.2, C15.2, C16.2, C17.2, C18.2, C19.2, C20.2, C21.2, C22.2, C23.2, C24.1, C25.1, C26.2, C27.2, C28.2, C29.2, D37.1 (K), D38.2 (A), D39.2 (A), J2.2, J3.A1 (GND_A), J3.A12 (GND_A), J3.B1 (GND_B), J3.B12 (GND_B), J3.SH1 (SHIELD), J3.SH2 (SHIELD), J4.2, J4.8, J4.14, J4.20, J4.26, J4.32, J4.38, J4.42, J4.48, J4.54, J4.60, J4.66, J4.72, J4.78, R26.2, R29.1, R30.1, SW1.1 (A), SW2.1 (A), SW3.1 (A), SW4.1 (A), SW5.1 (A), SW6.1 (A), SW7.1 (A), SW8.1 (A), SW9.1 (A), SW10.1 (A), SW11.1 (A), SW12.1 (A), SW13.1 (A), SW14.1 (A), SW15.1 (A), SW16.1 (A), SW17.1, SW18.1, SW19.1, SW20.1, SW21.1, SW22.1, SW23.1, SW24.1, SW25.1, SW26.1, SW27.1, SW28.1, SW29.1, SW31.1, U1.11 (GND), U2.11 (GND), U3.11 (GND), U4.11 (GND), U5.11 (GND), U6.62 (VREG_PGND), U6.81 (GND), U7.4 (GND), U8.6 (VSS), U8.11 (A0), U8.12 (A1), U8.13 (A2), U8.29 (EP), U9.6 (VSS), U9.12 (A1), U9.13 (A2), U9.29 (EP), U10.1 (GND), X1.2, X1.4
HLDA: J4.53, R52.2, U1.9 (D8)
HLTA: J4.68, R77.2, U3.9 (D8)
I2C1_SCK: U6.48 (GPIO39), U8.8 (SCK), U9.8 (SCK)
I2C1_SDA: U6.47 (GPIO38), U8.9 (SDA), U9.9 (SDA)
INP: J4.64, R46.2, U2.8 (D7)
INT: J4.75, R85.2, U3.4 (D3)
INTE: J4.51, R55.2, U1.7 (D6)
M1: J4.59, R49.2, U2.5 (D4)
MEMR: J4.63, R47.2, U2.7 (D6)
unnamed: C4.1, R27.1, X1.3
unnamed: D1.2 (A), R1.2
unnamed: D2.2 (A), R2.2
unnamed: D3.2 (A), R3.2
unnamed: D4.2 (A), R4.2
unnamed: D5.2 (A), R5.2
unnamed: D6.2 (A), R6.2
unnamed: D7.2 (A), R7.2
unnamed: D8.2 (A), R8.2
unnamed: D9.2 (A), R9.2
unnamed: D10.2 (A), R10.2
unnamed: D11.2 (A), R11.2
unnamed: D12.2 (A), R12.2
unnamed: D13.2 (A), R13.2
unnamed: D14.2 (A), R14.2
unnamed: D15.2 (A), R15.2
unnamed: D16.2 (A), R16.2
unnamed: D17.2 (A), R17.2
unnamed: D18.2 (A), R18.2
unnamed: D19.2 (A), R19.2
unnamed: D20.2 (A), R20.2
unnamed: D21.2 (A), R21.2
unnamed: D22.2 (A), R22.2
unnamed: D23.2 (A), R23.2
unnamed: D24.2 (A), R24.2
unnamed: D25.2 (A), R33.2
unnamed: D26.2 (A), R34.2
unnamed: D27.2 (A), R35.2
unnamed: D28.2 (A), R36.2
unnamed: D29.2 (A), R37.2
unnamed: D30.2 (A), R38.2
unnamed: D31.2 (A), R39.2
unnamed: D32.2 (A), R40.2
unnamed: D33.2 (A), R41.2
unnamed: D34.2 (A), R42.2
unnamed: D35.2 (A), R43.2
unnamed: D36.2 (A), R44.2
unnamed: D37.2 (A), R89.1
unnamed: J2.1, U6.33 (SWCLK)
unnamed: J2.3, U6.34 (SWD)
unnamed: J3.A5 (CC1), R29.2
unnamed: J3.B5 (CC2), R30.2
unnamed: R26.1, SW30.2
unnamed: R77.1, U6.77 (GPIO0)
unnamed: R78.1, U6.78 (GPIO1)
unnamed: R79.1, U6.79 (GPIO2)
unnamed: R80.1, U6.80 (GPIO3)
unnamed: R45.1, U6.1 (GPIO4)
unnamed: R46.1, U6.2 (GPIO5)
unnamed: R47.1, U6.3 (GPIO6)
unnamed: R48.1, U6.4 (GPIO7)
unnamed: R49.1, U6.6 (GPIO8)
unnamed: R50.1, U6.7 (GPIO9)
unnamed: R51.1, U6.8 (GPIO10)
unnamed: R52.1, U6.9 (GPIO11)
unnamed: R53.1, U6.11 (GPIO12)
unnamed: R54.1, U6.12 (GPIO13)
unnamed: R55.1, U6.13 (GPIO14)
unnamed: R56.1, U6.14 (GPIO15)
unnamed: R57.1, U6.16 (GPIO16)
unnamed: R58.1, U6.17 (GPIO17)
unnamed: R59.1, U6.18 (GPIO18)
unnamed: R60.1, U6.19 (GPIO19)
unnamed: R61.1, U6.20 (GPIO20)
unnamed: R62.1, U6.21 (GPIO21)
unnamed: R63.1, U6.22 (GPIO22)
unnamed: R64.1, U6.23 (GPIO23)
unnamed: R65.1, U6.25 (GPIO24)
unnamed: R66.1, U6.26 (GPIO25)
unnamed: R67.1, U6.27 (GPIO26)
unnamed: R68.1, U6.28 (GPIO27)
unnamed: R69.1, U6.36 (GPIO28)
unnamed: R70.1, U6.37 (GPIO29)
unnamed: R71.1, U6.38 (GPIO30)
unnamed: R72.1, U6.39 (GPIO31)
unnamed: R73.1, U6.40 (GPIO32)
unnamed: R74.1, U6.42 (GPIO33)
unnamed: R75.1, U6.43 (GPIO34)
unnamed: R76.1, U6.44 (GPIO35)
unnamed: R81.1, U6.49 (GPIO40_ADC0)
unnamed: R82.1, U6.52 (GPIO41_ADC1)
unnamed: R83.1, U6.53 (GPIO42_ADC2)
unnamed: R84.1, U6.54 (GPIO43_ADC3)
unnamed: R85.1, U6.55 (GPIO44_ADC4)
unnamed: R86.1, U6.56 (GPIO45_ADC5)
unnamed: R87.1, U6.57 (GPIO46_ADC6)
unnamed: R88.1, U6.58 (GPIO47_ADC7)
unnamed: U6.71 (QSPI_SCLK), U7.6 (CLK)
unnamed: U6.72 (QSPI_SD0), U7.7 (IO3)
unnamed: U6.74 (QSPI_SD1), U7.3 (IO2)
unnamed: U6.73 (QSPI_SD2), U7.2 (DO(IO1))
unnamed: U6.70 (QSPI_SD3), U7.5 (DI(IO0))
unnamed: R90.2, U6.75 (QSPI_SS), U7.1 (~CS)
unnamed: R32.1, U6.66 (USB_DM)
unnamed: R31.1, U6.67 (USB_DP)
unnamed: C9.2, R28.2, U6.61 (VREG_AVDD)
unnamed: L1.1, U6.63 (VREG_LX)
unnamed: C5.1, U6.30 (XIN), X1.1
unnamed: R27.2, U6.31 (XOUT)
OUT: J4.58, R50.2, U2.4 (D3)
PROT: J4.50, R56.2, U1.6 (D5)
PROTECT: R100.1, SW26.2, U8.25 (GPB0)
RESET: R98.1, SW24.2, U8.26 (GPB1)
RUN: R92.1, SW18.2, U8.18 (GPA1)
SINGLE_STEP: R93.1, SW19.2, U8.20 (GPA3)
STACK: J4.69, R78.2, U3.8 (D7)
STOP: R91.1, SW17.2, U8.19 (GPA2)
UNPROTECT: R101.1, SW27.2, U8.23 (GPA6)
VBUS: C28.1, D41.1 (K), J3.A4 (VBUS_A), J3.A9 (VBUS_A), J3.B4 (VBUS_B), J3.B9 (VBUS_B), R89.2, U10.3 (VI)
WAIT: J4.52, R54.2, U1.8 (D7)
WO: J4.71, R79.2, U3.6 (D5)

Notes on the sheet:
ADDR02
BUS09
ADDR08
CRYSTAL OSCILLATOR
BUS10
POWER SOURCES
I/O EXPANDERS
ADDR03
RP 2350 MICROCONTROLLER
IF THE LABEL IS BOLD, IT WILL EXIST ON THE OUTER FRONT PANEL
BUS18
BUS11
BUS17
ADDR06
BUS19
BUS01
DATA00
I2C LINES
DATA04
ADDR11
BUS06
1.1 V REGULATOR
DATA07
BUS03
SINK DRIVERS
BUS00
DATA06
FRONT PANEL SWITCHES
BOARD RESET
1.1 V POWER REGULATOR
QSPI FLASH
BUS02
BUS13
ADDR01
CHIP RESET
https://upload.wikimedia.org/wikipedia/commons/b/b2/MITS_Altair_8800_Front_Panel.jpg
BUS07
STATUS LINE LEDS
BUS08
DATA LINE LEDS
KEEP CLOSE TO BOARD
ADDR12
DATA03
USB REGULATOR
ADDRESS LINE LEDS
DATA05
BUS12
USED
ADDR05
ADDR09
Pin 53 & 54, and 68 & 69, shared
3.3V POWER REGULATOR
BUS14
UNUSED
DATA02
ADDR07
ADDR10
BUS16
ORIGINAL MAPPINGS
BUS04
ADDR15
FRONT PANEL BUTTONS
USB-C PORT
PWR_FLAG
DO NOT CONNECT SBU
BUS ASSIGNMENT
ADDR14
ADDR00
BUS05
DATA01
ADDR13
ADDR04
BOARD CONNECTORS
BUS15

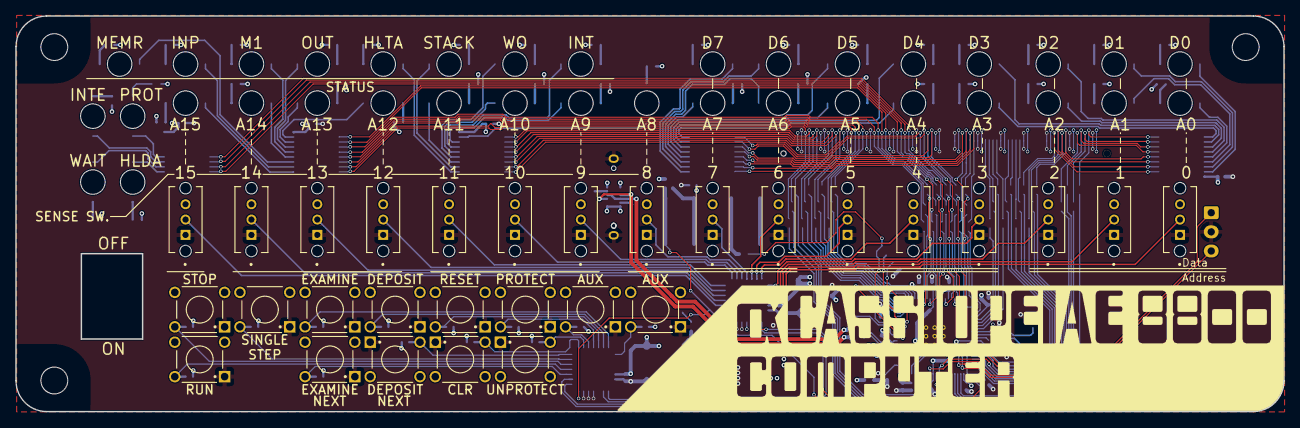
[picture p26: board panel.kicad_pcb from above]

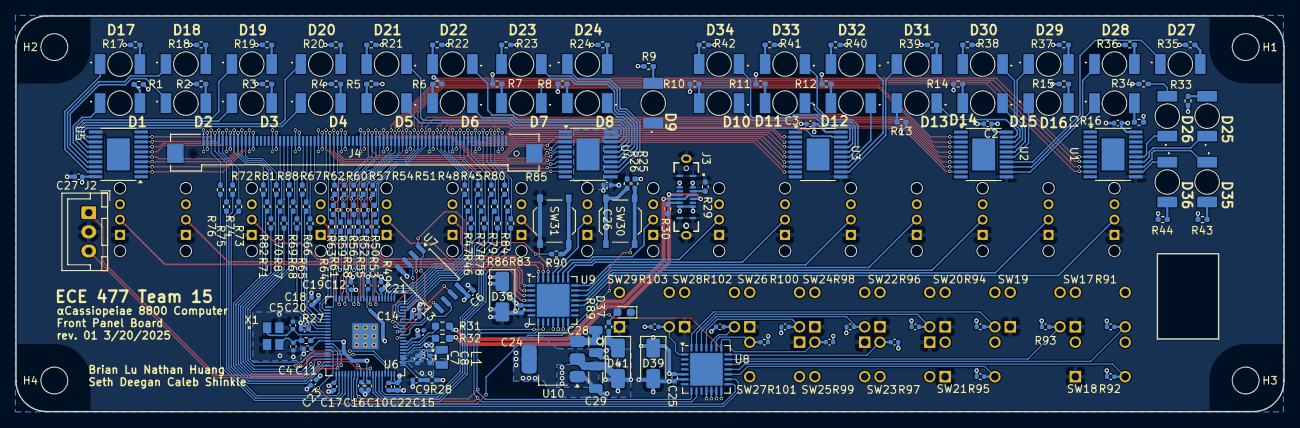
[picture p27: board panel.kicad_pcb from below]

Board: 4 copper layers, 165.5 x 51.6 mm, 222 parts (189 on the bottom side), 220 nets.
