AlphaCassiopeiae/8800/ecad/card/card.kicad_pcb

## KiCad design ecad/card/card.kicad_pcb (2025-03-26)

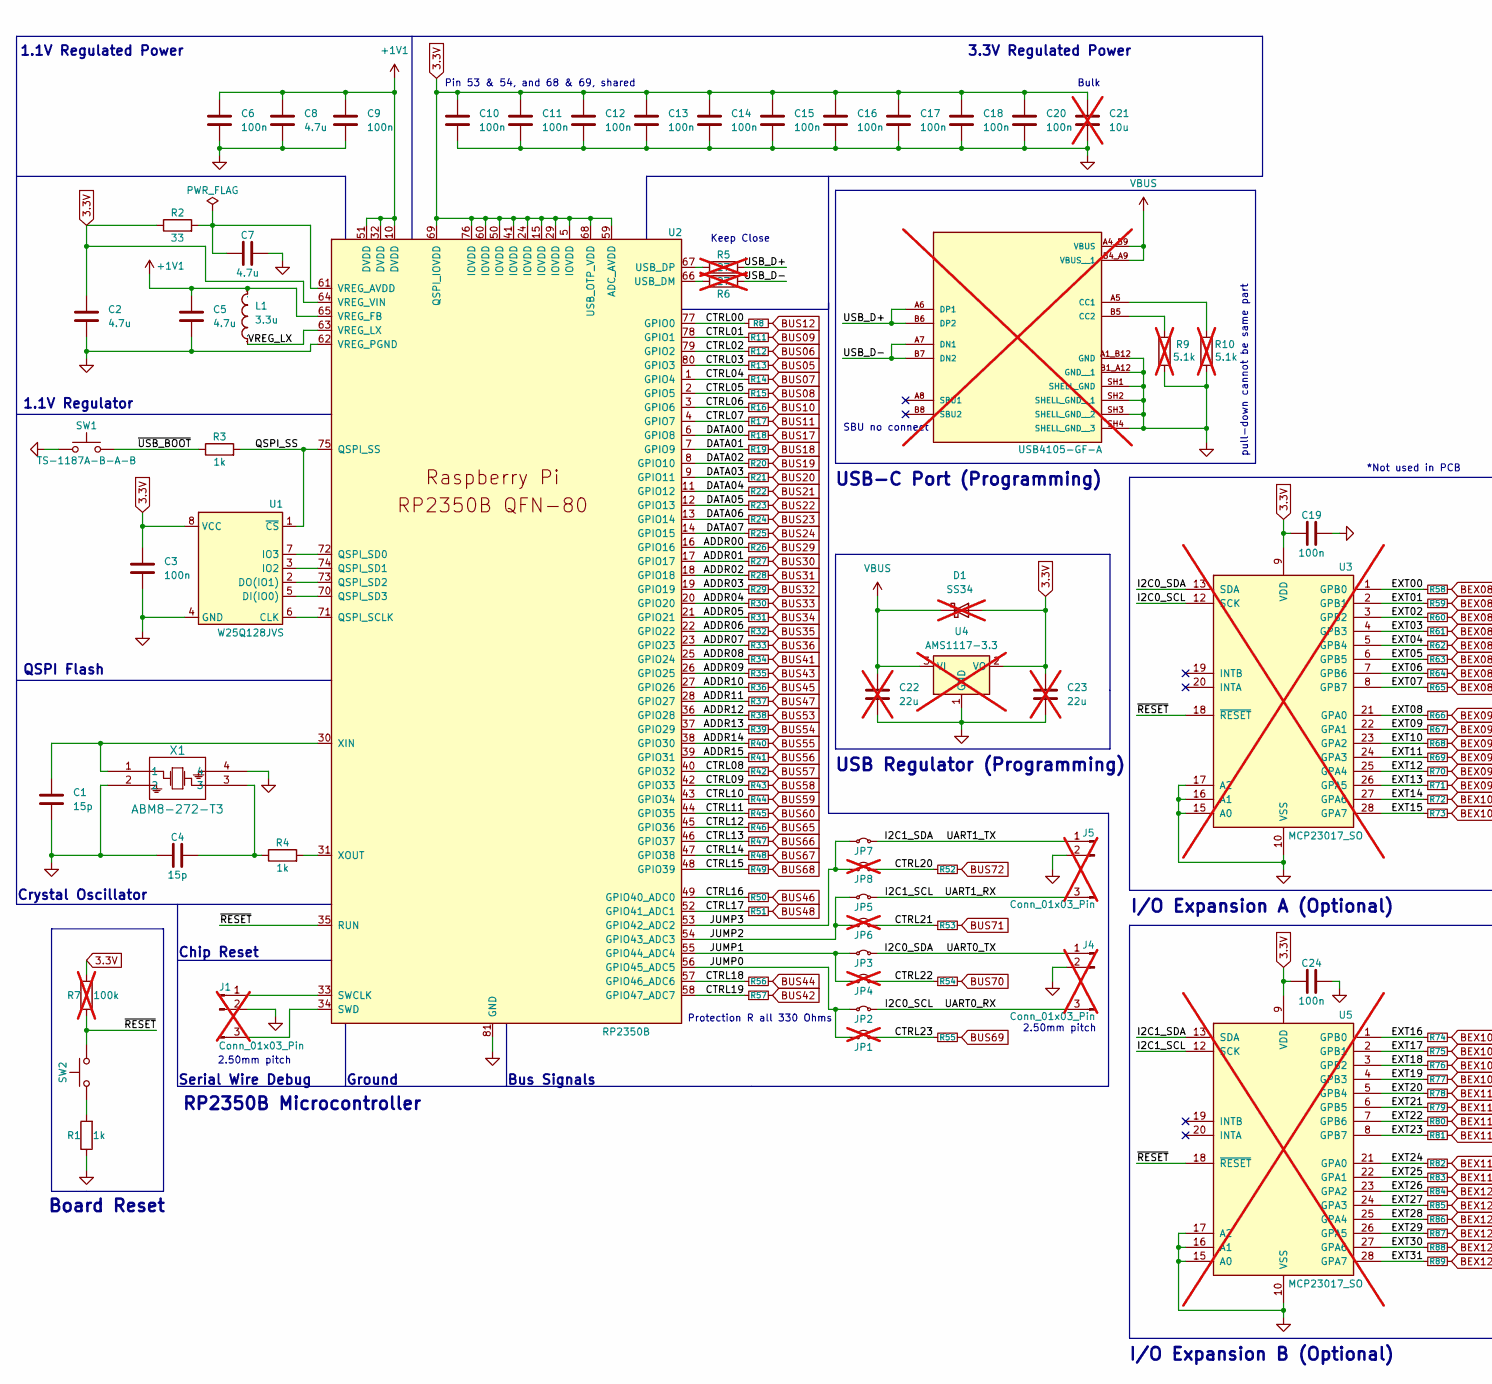
[picture p28: schematic card.kicad_sch, part in row 1, column 1]

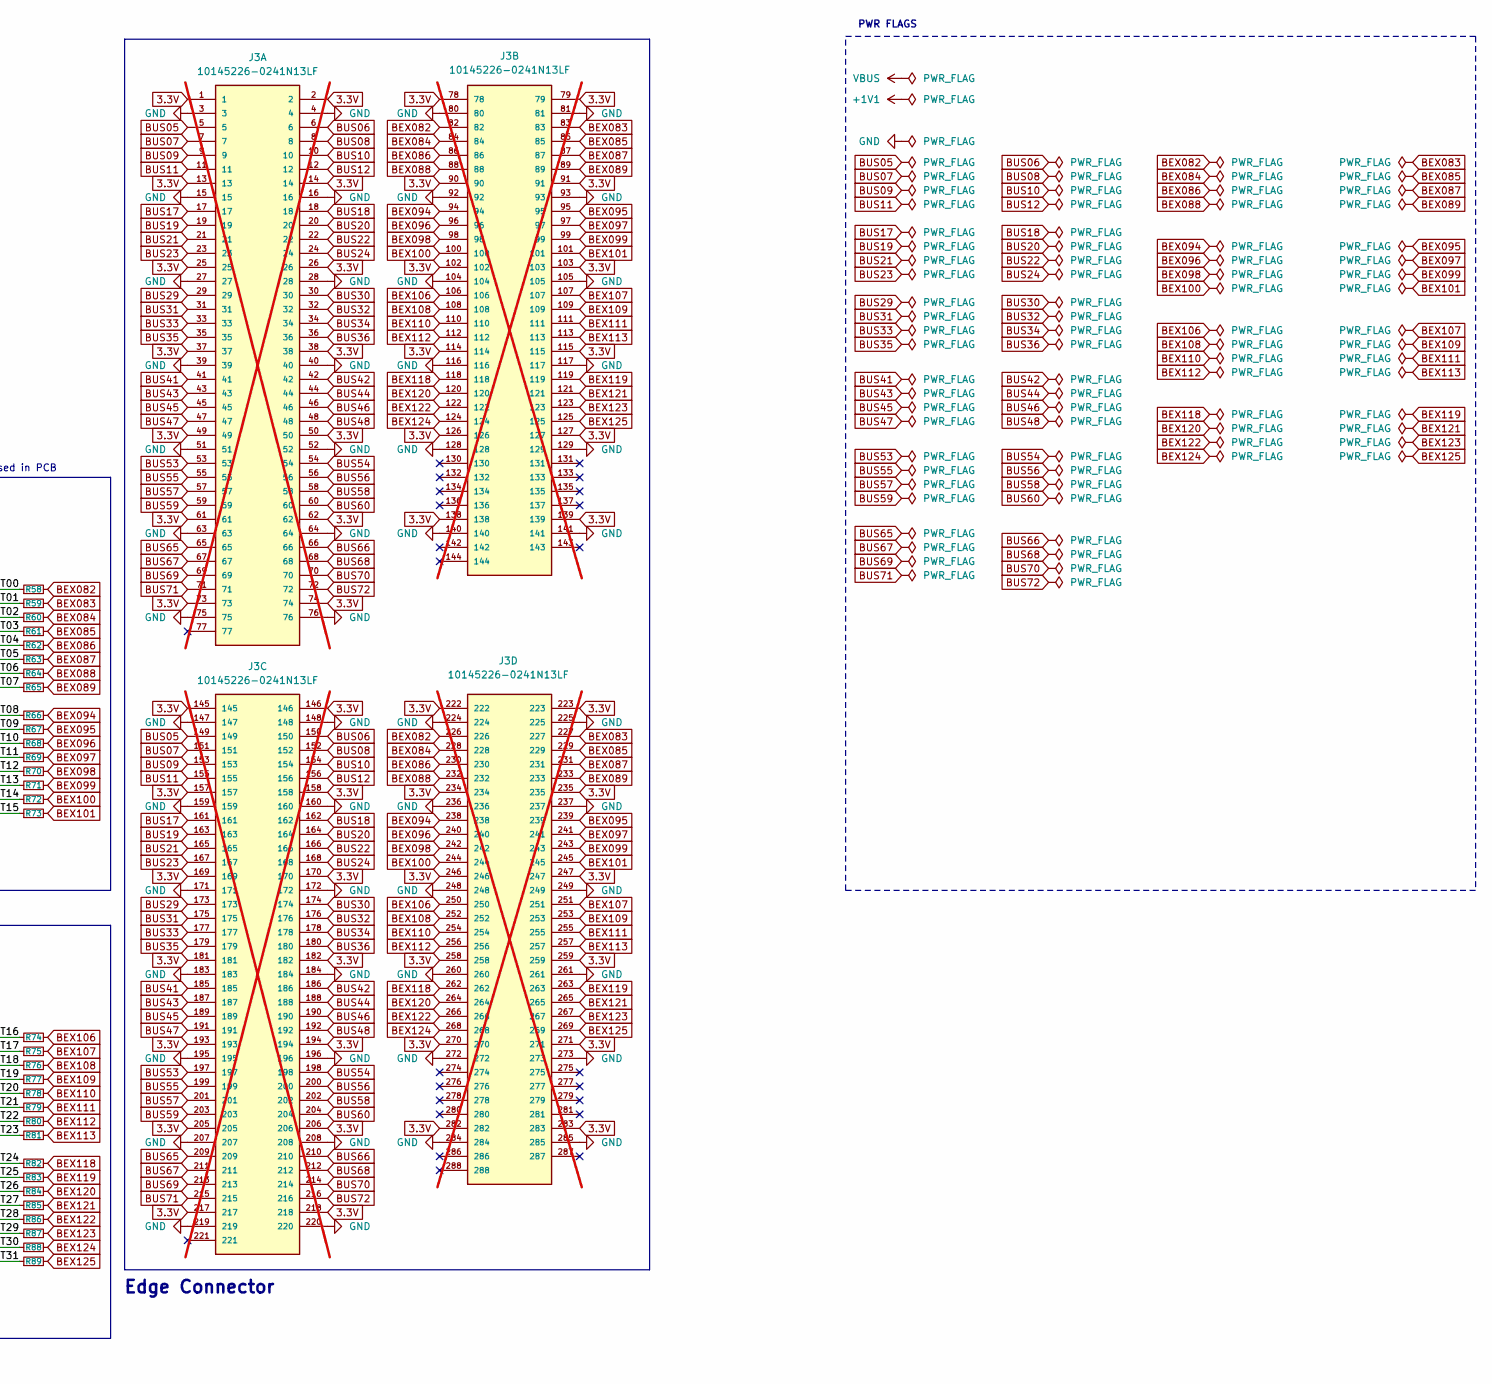
[picture p29: schematic card.kicad_sch, part in row 1, column 2]

Parts:
C1, C4: 15p; C_0402_1005Metric
C2, C7, C8: 4.7u; C_0402_1005Metric
C3, C6, C9, C11, C12, C13, C14, C15, C16, C17, C18, C19, C20, C24: 100n; C_0402_1005Metric
C5: 4.7u; C_0603_1608Metric
C10: 100n; C_0603_1608Metric
C21: 10u; C_0805_2012Metric_Pad1.18x1.45mm_HandSolder; not fitted
C22, C23: 22u; C_1206_3216Metric; not fitted
D1: SS34; D_SMA; not fitted
J1, J4, J5: Conn_01x03_Pin; JST_XH_S3B-XH-A-1_1x03_P2.50mm_Horizontal; not fitted
J2: USB4105-GF-A; GCT_USB4105-GF-A; PARTREV B4; not fitted
J3: 10145226-0241N13LF; DIMM-DDR4; PARTREV E; not fitted
JP1, JP4, JP6, JP8: Jumper_2_Small_Open; R_0402_1005Metric_Pad0.72x0.64mm_HandSolder; not fitted
JP2, JP3, JP5, JP7: 0402WGF0000TCE; R_0402_1005Metric_Pad0.72x0.64mm_HandSolder
L1: 3.3u; IND-SMD_L2.0-W1.6_AOTA-B201610S3R3-101-T; Manufacturer Part AOTA-B201610S3R3-101-T; LCSC Part # C42411119
R1, R3, R4: 1k; R_0402_1005Metric
R2: 33; R_0402_1005Metric
R5, R6: 27; R_0603_1608Metric_Pad0.98x0.95mm_HandSolder; not fitted
R7: 100k; R_0805_2012Metric_Pad1.20x1.40mm_HandSolder; not fitted
R8, R11, R12, R13, R14, R15, R16, R17, R18, R19, R20, R21, R22, R23, R24, R25, R26, R27, R28, R29, R30, R31, R32, R33, R34, R35, R36, R37, R38, R39, R40, R41, R42, R43, R44, R45, R46, R47, R48, R49, R50, R51, R52, R53, R54, R55, R56, R57, R58, R59, R60, R61, R62, R63, R64, R65, R66, R67, R68, R69, R70, R71, R72, R73, R74, R75, R76, R77, R78, R79, R80, R81, R82, R83, R84, R85, R86, R87, R88, R89: 330; R_0402_1005Metric
R9, R10: 5.1k; R_0603_1608Metric_Pad0.98x0.95mm_HandSolder; not fitted
SW1, SW2: TS-1187A-B-A-B; SW_Push_1P1T_XKB_TS-1187A
U1: W25Q128JVS; SOIC-8_5.23x5.23mm_P1.27mm
U2: RP2350B; RP2350-QFN-80-1EP_10x10_P0.4mm_EP3.4x3.4mm_ThermalVias
U3, U5: MCP23017_SO; SOIC-28W_7.5x17.9mm_P1.27mm; not fitted
U4: AMS1117-3.3; SOT-223-3_TabPin2; not fitted
X1: ABM8-272-T3; ABM8-272-T3_ABR

Connections:
3.3V: C2.1, C3.1, C10.1, C11.1, C12.1, C13.1, C14.1, C15.1, C16.1, C17.1, C18.1, C19.1, C20.1, C21.1, C23.1, C24.1, D1.2 (A), J3.1, J3.2, J3.13, J3.14, J3.25, J3.26, J3.37, J3.38, J3.49, J3.50, J3.61, J3.62, J3.73, J3.74, J3.78, J3.79, J3.90, J3.91, J3.102, J3.103, J3.114, J3.115, J3.126, J3.127, J3.138, J3.139, J3.145, J3.146, J3.157, J3.158, J3.169, J3.170, J3.181, J3.182, J3.193, J3.194, J3.205, J3.206, J3.217, J3.218, J3.222, J3.223, J3.234, J3.235, J3.246, J3.247, J3.258, J3.259, J3.270, J3.271, J3.282, J3.283, R2.1, R7.2, U1.8 (VCC), U2.5 (IOVDD), U2.15 (IOVDD), U2.24 (IOVDD), U2.29 (IOVDD), U2.41 (IOVDD), U2.50 (IOVDD), U2.59 (ADC_AVDD), U2.60 (IOVDD), U2.64 (VREG_VIN), U2.68 (USB_OTP_VDD), U2.69 (QSPI_IOVDD), U2.76 (IOVDD), U3.9 (VDD), U4.2 (VO), U5.9 (VDD)
+1V1: C5.1, C6.1, C8.1, C9.1, L1.2, U2.10 (DVDD), U2.32 (DVDD), U2.51 (DVDD), U2.65 (VREG_FB)
/ADDR00: R26.1, U2.16 (GPIO16)
/ADDR01: R27.1, U2.17 (GPIO17)
/ADDR02: R28.1, U2.18 (GPIO18)
/ADDR03: R29.1, U2.19 (GPIO19)
/ADDR04: R30.1, U2.20 (GPIO20)
/ADDR05: R31.1, U2.21 (GPIO21)
/ADDR06: R32.1, U2.22 (GPIO22)
/ADDR07: R33.1, U2.23 (GPIO23)
/ADDR08: R34.1, U2.25 (GPIO24)
/ADDR09: R35.1, U2.26 (GPIO25)
/ADDR10: R36.1, U2.27 (GPIO26)
/ADDR11: R37.1, U2.28 (GPIO27)
/ADDR12: R38.1, U2.36 (GPIO28)
/ADDR13: R39.1, U2.37 (GPIO29)
/ADDR14: R40.1, U2.38 (GPIO30)
/ADDR15: R41.1, U2.39 (GPIO31)
/CTRL00: R8.1, U2.77 (GPIO0)
/CTRL01: R11.1, U2.78 (GPIO1)
/CTRL02: R12.1, U2.79 (GPIO2)
/CTRL03: R13.1, U2.80 (GPIO3)
/CTRL04: R14.1, U2.1 (GPIO4)
/CTRL05: R15.1, U2.2 (GPIO5)
/CTRL06: R16.1, U2.3 (GPIO6)
/CTRL07: R17.1, U2.4 (GPIO7)
/CTRL08: R42.1, U2.40 (GPIO32)
/CTRL09: R43.1, U2.42 (GPIO33)
/CTRL10: R44.1, U2.43 (GPIO34)
/CTRL11: R45.1, U2.44 (GPIO35)
/CTRL12: R46.1, U2.45 (GPIO36)
/CTRL13: R47.1, U2.46 (GPIO37)
/CTRL14: R48.1, U2.47 (GPIO38)
/CTRL15: R49.1, U2.48 (GPIO39)
/CTRL16: R50.1, U2.49 (GPIO40_ADC0)
/CTRL17: R51.1, U2.52 (GPIO41_ADC1)
/CTRL18: R56.1, U2.57 (GPIO46_ADC6)
/CTRL19: R57.1, U2.58 (GPIO47_ADC7)
/CTRL20: JP8.2 (B), R52.1
/CTRL21: JP6.2 (B), R53.1
/CTRL22: JP4.2 (B), R54.1
/CTRL23: JP1.2 (B), R55.1
/DATA00: R18.1, U2.6 (GPIO8)
/DATA01: R19.1, U2.7 (GPIO9)
/DATA02: R20.1, U2.8 (GPIO10)
/DATA03: R21.1, U2.9 (GPIO11)
/DATA04: R22.1, U2.11 (GPIO12)
/DATA05: R23.1, U2.12 (GPIO13)
/DATA06: R24.1, U2.13 (GPIO14)
/DATA07: R25.1, U2.14 (GPIO15)
/EXT00: R58.1, U3.1 (GPB0)
/EXT01: R59.1, U3.2 (GPB1)
/EXT02: R60.1, U3.3 (GPB2)
/EXT03: R61.1, U3.4 (GPB3)
/EXT04: R62.1, U3.5 (GPB4)
/EXT05: R63.1, U3.6 (GPB5)
/EXT06: R64.1, U3.7 (GPB6)
/EXT07: R65.1, U3.8 (GPB7)
/EXT08: R66.1, U3.21 (GPA0)
/EXT09: R67.1, U3.22 (GPA1)
/EXT10: R68.1, U3.23 (GPA2)
/EXT11: R69.1, U3.24 (GPA3)
/EXT12: R70.1, U3.25 (GPA4)
/EXT13: R71.1, U3.26 (GPA5)
/EXT14: R72.1, U3.27 (GPA6)
/EXT15: R73.1, U3.28 (GPA7)
/EXT16: R74.1, U5.1 (GPB0)
/EXT17: R75.1, U5.2 (GPB1)
/EXT18: R76.1, U5.3 (GPB2)
/EXT19: R77.1, U5.4 (GPB3)
/EXT20: R78.1, U5.5 (GPB4)
/EXT21: R79.1, U5.6 (GPB5)
/EXT22: R80.1, U5.7 (GPB6)
/EXT23: R81.1, U5.8 (GPB7)
/EXT24: R82.1, U5.21 (GPA0)
/EXT25: R83.1, U5.22 (GPA1)
/EXT26: R84.1, U5.23 (GPA2)
/EXT27: R85.1, U5.24 (GPA3)
/EXT28: R86.1, U5.25 (GPA4)
/EXT29: R87.1, U5.26 (GPA5)
/EXT30: R88.1, U5.27 (GPA6)
/EXT31: R89.1, U5.28 (GPA7)
/I2C0_SCL: J4.3, JP2.2 (B), U3.12 (SCK)
/I2C0_SDA: J4.1, JP3.2 (B), U3.13 (SDA)
/I2C1_SCL: J5.3, JP5.2 (B), U5.12 (SCK)
/I2C1_SDA: J5.1, JP7.2 (B), U5.13 (SDA)
/JUMP0: JP1.1 (A), JP2.1 (A), U2.56 (GPIO45_ADC5)
/JUMP1: JP3.1 (A), JP4.1 (A), U2.55 (GPIO44_ADC4)
/JUMP2: JP5.1 (A), JP6.1 (A), U2.54 (GPIO43_ADC3)
/JUMP3: JP7.1 (A), JP8.1 (A), U2.53 (GPIO42_ADC2)
/QSPI_SS: R3.2, U1.1 (~CS), U2.75 (QSPI_SS)
/USB_D+: J2.A6 (DP1), J2.B6 (DP2), R5.2
/USB_D-: J2.A7 (DN1), J2.B7 (DN2), R6.1
/VREG_LX: L1.1, U2.63 (VREG_LX)
/~RESET: R7.1, SW2.2, U2.35 (RUN), U3.18 (~RESET), U5.18 (~RESET)
/~USB_BOOT: R3.1, SW1.2
BEX082: J3.82, J3.226, R58.2
BEX083: J3.83, J3.227, R59.2
BEX084: J3.84, J3.228, R60.2
BEX085: J3.85, J3.229, R61.2
BEX086: J3.86, J3.230, R62.2
BEX087: J3.87, J3.231, R63.2
BEX088: J3.88, J3.232, R64.2
BEX089: J3.89, J3.233, R65.2
BEX094: J3.94, J3.238, R66.2
BEX095: J3.95, J3.239, R67.2
BEX096: J3.96, J3.240, R68.2
BEX097: J3.97, J3.241, R69.2
BEX098: J3.98, J3.242, R70.2
BEX099: J3.99, J3.243, R71.2
BEX100: J3.100, J3.244, R72.2
BEX101: J3.101, J3.245, R73.2
BEX106: J3.106, J3.250, R74.2
BEX107: J3.107, J3.251, R75.2
BEX108: J3.108, J3.252, R76.2
BEX109: J3.109, J3.253, R77.2
BEX110: J3.110, J3.254, R78.2
BEX111: J3.111, J3.255, R79.2
BEX112: J3.112, J3.256, R80.2
BEX113: J3.113, J3.257, R81.2
BEX118: J3.118, J3.262, R82.2
BEX119: J3.119, J3.263, R83.2
BEX120: J3.120, J3.264, R84.2
BEX121: J3.121, J3.265, R85.2
BEX122: J3.122, J3.266, R86.2
BEX123: J3.123, J3.267, R87.2
BEX124: J3.124, J3.268, R88.2
BEX125: J3.125, J3.269, R89.2
BUS05: J3.5, J3.149, R13.2
BUS06: J3.6, J3.150, R12.2
BUS07: J3.7, J3.151, R14.2
BUS08: J3.8, J3.152, R15.2
BUS09: J3.9, J3.153, R11.2
BUS10: J3.10, J3.154, R16.2
BUS11: J3.11, J3.155, R17.2
BUS12: J3.12, J3.156, R8.2
BUS17: J3.17, J3.161, R18.2
BUS18: J3.18, J3.162, R19.2
BUS19: J3.19, J3.163, R20.2
BUS20: J3.20, J3.164, R21.2
BUS21: J3.21, J3.165, R22.2
BUS22: J3.22, J3.166, R23.2
BUS23: J3.23, J3.167, R24.2
BUS24: J3.24, J3.168, R25.2
BUS29: J3.29, J3.173, R26.2
BUS30: J3.30, J3.174, R27.2
BUS31: J3.31, J3.175, R28.2
BUS32: J3.32, J3.176, R29.2
BUS33: J3.33, J3.177, R30.2
BUS34: J3.34, J3.178, R31.2
BUS35: J3.35, J3.179, R32.2
BUS36: J3.36, J3.180, R33.2
BUS41: J3.41, J3.185, R34.2
BUS42: J3.42, J3.186, R57.2
BUS43: J3.43, J3.187, R35.2
BUS44: J3.44, J3.188, R56.2
BUS45: J3.45, J3.189, R36.2
BUS46: J3.46, J3.190, R50.2
BUS47: J3.47, J3.191, R37.2
BUS48: J3.48, J3.192, R51.2
BUS53: J3.53, J3.197, R38.2
BUS54: J3.54, J3.198, R39.2
BUS55: J3.55, J3.199, R40.2
BUS56: J3.56, J3.200, R41.2
BUS57: J3.57, J3.201, R42.2
BUS58: J3.58, J3.202, R43.2
BUS59: J3.59, J3.203, R44.2
BUS60: J3.60, J3.204, R45.2
BUS65: J3.65, J3.209, R46.2
BUS66: J3.66, J3.210, R47.2
BUS67: J3.67, J3.211, R48.2
BUS68: J3.68, J3.212, R49.2
BUS69: J3.69, J3.213, R55.2
BUS70: J3.70, J3.214, R54.2
BUS71: J3.71, J3.215, R53.2
BUS72: J3.72, J3.216, R52.2
GND: C1.2, C2.2, C3.2, C4.1, C5.2, C6.2, C7.2, C8.2, C9.2, C10.2, C11.2, C12.2, C13.2, C14.2, C15.2, C16.2, C17.2, C18.2, C19.2, C20.2, C21.2, C22.2, C23.2, C24.2, J1.2, J2.A1_B12 (GND), J2.B1_A12 (GND__1), J2.SH1 (SHELL_GND), J2.SH2 (SHELL_GND__1), J2.SH3 (SHELL_GND__2), J2.SH4 (SHELL_GND__3), J3.3, J3.4, J3.15, J3.16, J3.27, J3.28, J3.39, J3.40, J3.51, J3.52, J3.63, J3.64, J3.75, J3.76, J3.80, J3.81, J3.92, J3.93, J3.104, J3.105, J3.116, J3.117, J3.128, J3.129, J3.140, J3.141, J3.147, J3.148, J3.159, J3.160, J3.171, J3.172, J3.183, J3.184, J3.195, J3.196, J3.207, J3.208, J3.219, J3.220, J3.224, J3.225, J3.236, J3.237, J3.248, J3.249, J3.260, J3.261, J3.272, J3.273, J3.284, J3.285, J4.2, J5.2, R1.1, R9.2, R10.2, SW1.1, U1.4 (GND), U2.62 (VREG_PGND), U2.81 (GND), U3.10 (VSS), U3.15 (A0), U3.16 (A1), U3.17 (A2), U4.1 (GND), U5.10 (VSS), U5.15 (A0), U5.16 (A1), U5.17 (A2), X1.2, X1.4
unnamed: C4.2, R4.1, X1.3
unnamed: J1.1, U2.33 (SWCLK)
unnamed: J1.3, U2.34 (SWD)
unnamed: J2.A5 (CC1), R10.1
unnamed: J2.B5 (CC2), R9.1
unnamed: R1.2, SW2.1
unnamed: U1.6 (CLK), U2.71 (QSPI_SCLK)
unnamed: U1.5 (DI(IO0)), U2.70 (QSPI_SD3)
unnamed: U1.2 (DO(IO1)), U2.73 (QSPI_SD2)
unnamed: U1.3 (IO2), U2.74 (QSPI_SD1)
unnamed: U1.7 (IO3), U2.72 (QSPI_SD0)
unnamed: R6.2, U2.66 (USB_DM)
unnamed: R5.1, U2.67 (USB_DP)
unnamed: C7.1, R2.2, U2.61 (VREG_AVDD)
unnamed: C1.1, U2.30 (XIN), X1.1
unnamed: R4.2, U2.31 (XOUT)
VBUS: C22.1, D1.1 (K), J2.A4_B9 (VBUS), J2.B4_A9 (VBUS__1), U4.3 (VI)

Notes on the sheet:
Crystal Oscillator
Ground
Chip Reset
Protection R all 330 Ohms
SBU no connect
1.1V Regulator
1.1V Regulated Power
2.50mm pitch
I/O Expansion B (Optional)
Bulk
RP2350B Microcontroller
pull-down cannot be same part
Keep Close
USB Regulator (Programming)
QSPI Flash
I/O Expansion A (Optional)
Board Reset
Pin 53 & 54, and 68 & 69, shared
Serial Wire Debug
USB-C Port (Programming)
3.3V Regulated Power
Edge Connector
*Not used in PCB
PWR FLAGS
Bus Signals

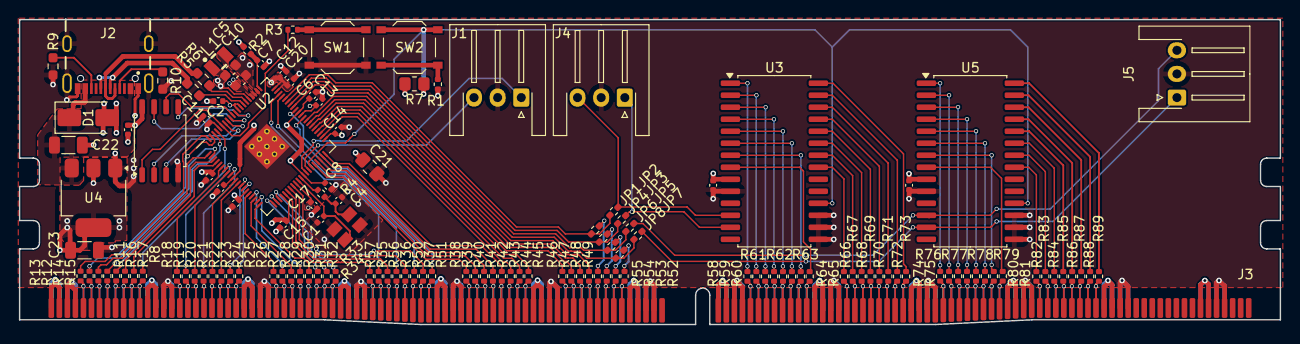
[picture p30: board card.kicad_pcb from above]

Board: 4 copper layers, 133.4 x 32.2 mm, 136 parts (0 on the bottom side), 194 nets.
