AlphaCassiopeiae/8800/ecad/backplane/backplane.kicad_pcb

## KiCad design ecad/backplane/backplane.kicad_pcb (2025-03-26)

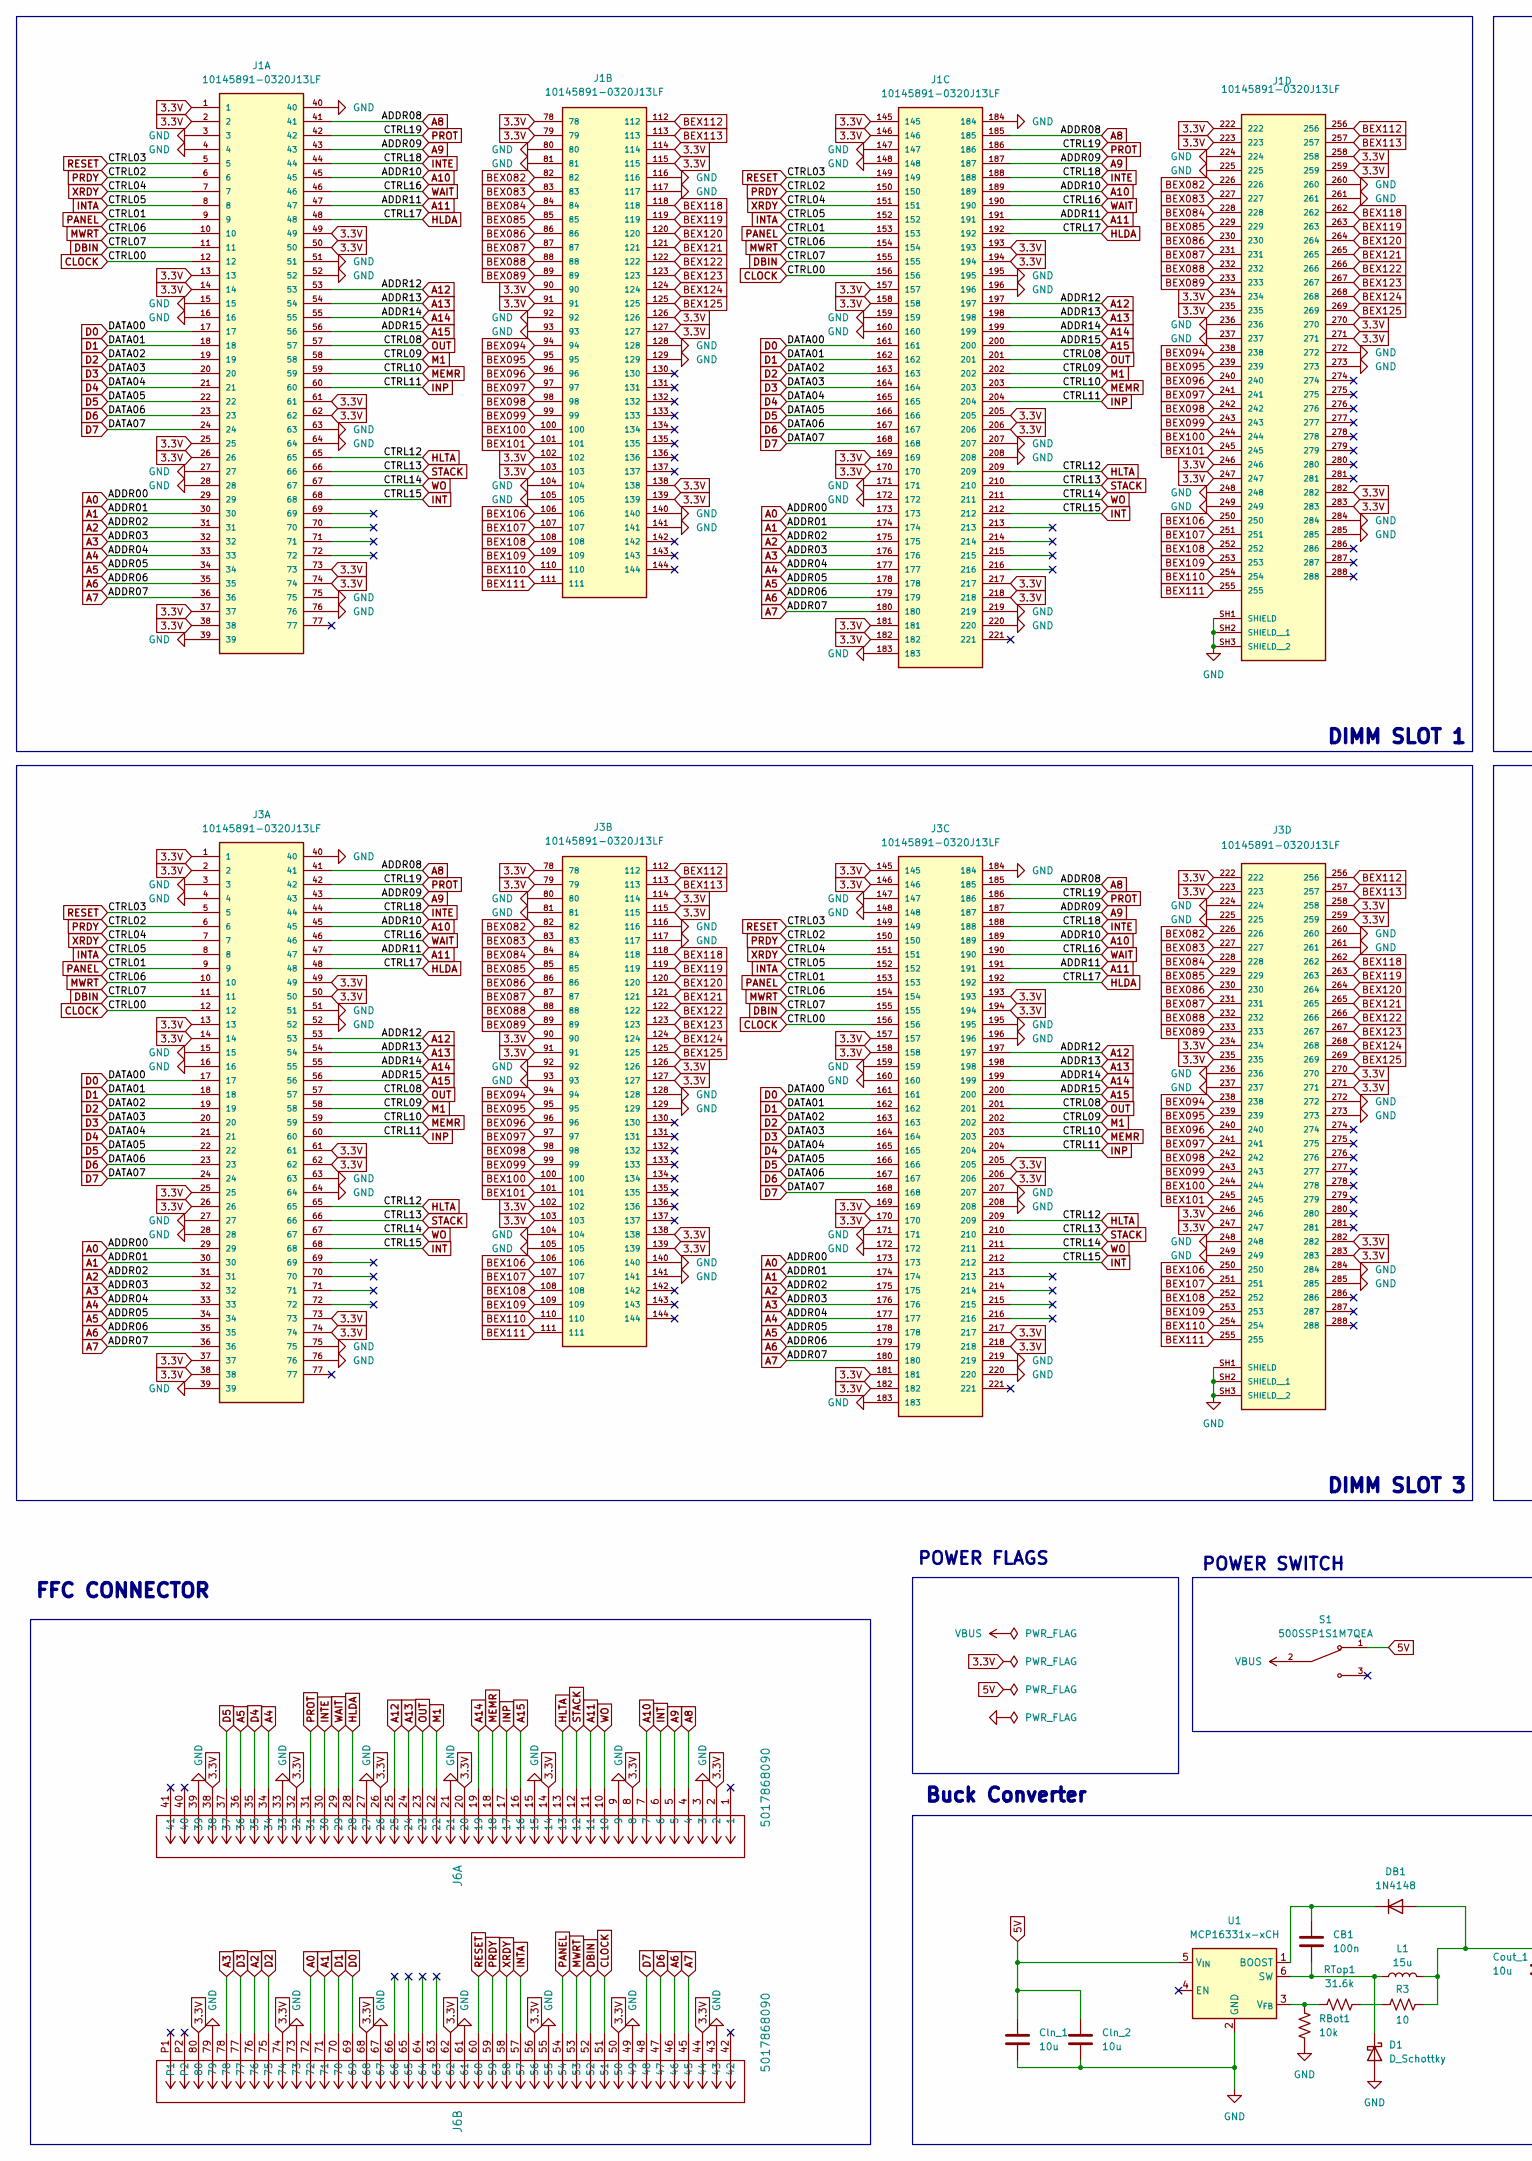
[picture p31: schematic backplane.kicad_sch, 8800 Back Plane, part in row 1, column 1]

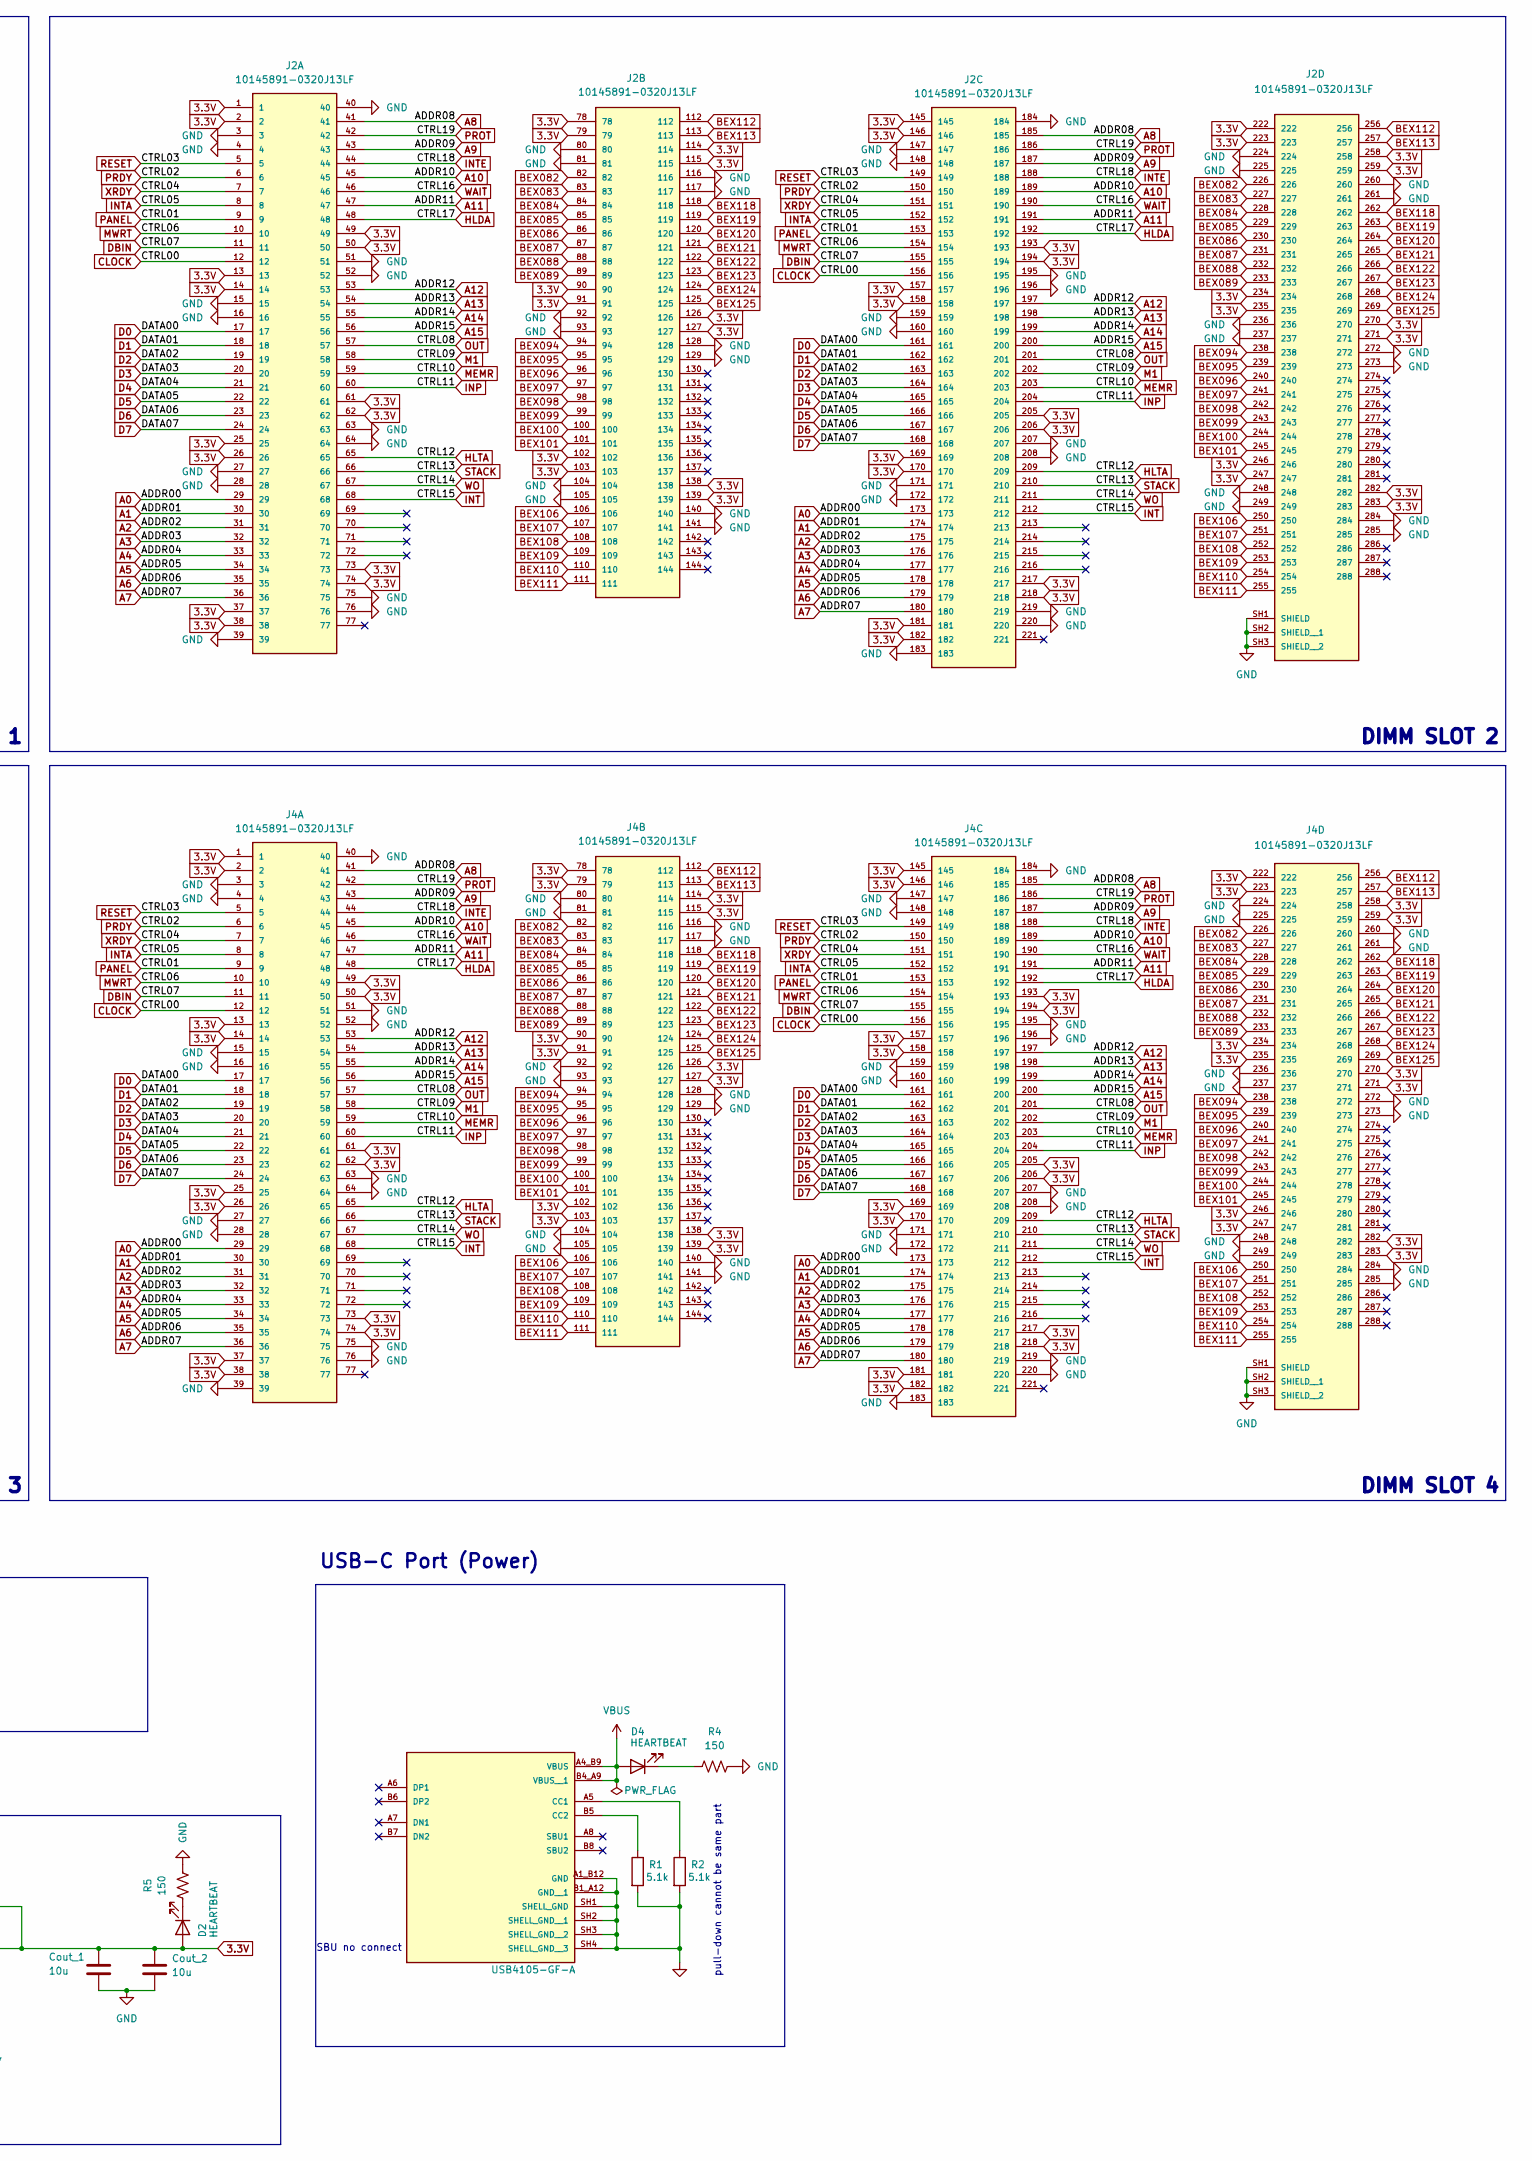
[picture p32: schematic backplane.kicad_sch, 8800 Back Plane, part in row 1, column 2]

Parts:
CB1: 100n; C_0402_1005Metric_Pad0.74x0.62mm_HandSolder
Cln_1, Cln_2: 10u; C_0603_1608Metric_Pad1.08x0.95mm_HandSolder
Cout_1, Cout_2: 10u; C_0402_1005Metric_Pad0.74x0.62mm_HandSolder
D1: D_Schottky; DO-214BA_MCH-L
D2, D4: HEARTBEAT; LED_0603_1608Metric_Pad1.05x0.95mm_HandSolder
DB1: 1N4148; D_0402_1005Metric_Pad0.77x0.64mm_HandSolder
J1, J2, J3, J4: 10145891-0320J13LF; AMPHENOL_10145891-0320J13LF; PARTREV K
J5: USB4105-GF-A; GCT_USB4105-GF-A; PARTREV B4
J6: 5017868090; CON_5017868090
L1: 15u; DR73-150-R
R1, R2: 5.1k; R_0402_1005Metric
R3: 10; R_0402_1005Metric_Pad0.72x0.64mm_HandSolder
R4, R5: 150; R_0402_1005Metric
RBot1: 10k; R_0402_1005Metric_Pad0.72x0.64mm_HandSolder
RTop1: 31.6k; R_0402_1005Metric_Pad0.72x0.64mm_HandSolder
S1: 500SSP1S1M7QEA; SW_500SSP1S1M7QEA; PARTREV 18/10/22
U1: MCP16331x-xCH; SOT-23-6

Connections:
3.3V: Cout_1.1, Cout_2.1, D2.2 (A), DB1.2 (A), J1.1, J1.2, J1.13, J1.14, J1.25, J1.26, J1.37, J1.38, J1.49, J1.50, J1.61, J1.62, J1.73, J1.74, J1.78, J1.79, J1.90, J1.91, J1.102, J1.103, J1.114, J1.115, J1.126, J1.127, J1.138, J1.139, J1.145, J1.146, J1.157, J1.158, J1.169, J1.170, J1.181, J1.182, J1.193, J1.194, J1.205, J1.206, J1.217, J1.218, J1.222, J1.223, J1.234, J1.235, J1.246, J1.247, J1.258, J1.259, J1.270, J1.271, J1.282, J1.283, J2.1, J2.2, J2.13, J2.14, J2.25, J2.26, J2.37, J2.38, J2.49, J2.50, J2.61, J2.62, J2.73, J2.74, J2.78, J2.79, J2.90, J2.91, J2.102, J2.103, J2.114, J2.115, J2.126, J2.127, J2.138, J2.139, J2.145, J2.146, J2.157, J2.158, J2.169, J2.170, J2.181, J2.182, J2.193, J2.194, J2.205, J2.206, J2.217, J2.218, J2.222, J2.223, J2.234, J2.235, J2.246, J2.247, J2.258, J2.259, J2.270, J2.271, J2.282, J2.283, J3.1, J3.2, J3.13, J3.14, J3.25, J3.26, J3.37, J3.38, J3.49, J3.50, J3.61, J3.62, J3.73, J3.74, J3.78, J3.79, J3.90, J3.91, J3.102, J3.103, J3.114, J3.115, J3.126, J3.127, J3.138, J3.139, J3.145, J3.146, J3.157, J3.158, J3.169, J3.170, J3.181, J3.182, J3.193, J3.194, J3.205, J3.206, J3.217, J3.218, J3.222, J3.223, J3.234, J3.235, J3.246, J3.247, J3.258, J3.259, J3.270, J3.271, J3.282, J3.283, J4.1, J4.2, J4.13, J4.14, J4.25, J4.26, J4.37, J4.38, J4.49, J4.50, J4.61, J4.62, J4.73, J4.74, J4.78, J4.79, J4.90, J4.91, J4.102, J4.103, J4.114, J4.115, J4.126, J4.127, J4.138, J4.139, J4.145, J4.146, J4.157, J4.158, J4.169, J4.170, J4.181, J4.182, J4.193, J4.194, J4.205, J4.206, J4.217, J4.218, J4.222, J4.223, J4.234, J4.235, J4.246, J4.247, J4.258, J4.259, J4.270, J4.271, J4.282, J4.283, J6.2, J6.8, J6.14, J6.20, J6.26, J6.32, J6.38, J6.44, J6.50, J6.56, J6.62, J6.68, J6.74, J6.80, L1.2, R3.2
5V: Cln_1.1, Cln_2.1, S1.1, U1.5 (V_{IN})
A0: J1.29, J1.173, J2.29, J2.173, J3.29, J3.173, J4.29, J4.173, J6.72
A1: J1.30, J1.174, J2.30, J2.174, J3.30, J3.174, J4.30, J4.174, J6.71
A2: J1.31, J1.175, J2.31, J2.175, J3.31, J3.175, J4.31, J4.175, J6.76
A3: J1.32, J1.176, J2.32, J2.176, J3.32, J3.176, J4.32, J4.176, J6.78
A4: J1.33, J1.177, J2.33, J2.177, J3.33, J3.177, J4.33, J4.177, J6.34
A5: J1.34, J1.178, J2.34, J2.178, J3.34, J3.178, J4.34, J4.178, J6.36
A6: J1.35, J1.179, J2.35, J2.179, J3.35, J3.179, J4.35, J4.179, J6.46
A7: J1.36, J1.180, J2.36, J2.180, J3.36, J3.180, J4.36, J4.180, J6.45
A8: J1.41, J1.185, J2.41, J2.185, J3.41, J3.185, J4.41, J4.185, J6.4
A9: J1.43, J1.187, J2.43, J2.187, J3.43, J3.187, J4.43, J4.187, J6.5
A10: J1.45, J1.189, J2.45, J2.189, J3.45, J3.189, J4.45, J4.189, J6.7
A11: J1.47, J1.191, J2.47, J2.191, J3.47, J3.191, J4.47, J4.191, J6.11
A12: J1.53, J1.197, J2.53, J2.197, J3.53, J3.197, J4.53, J4.197, J6.25
A13: J1.54, J1.198, J2.54, J2.198, J3.54, J3.198, J4.54, J4.198, J6.24
A14: J1.55, J1.199, J2.55, J2.199, J3.55, J3.199, J4.55, J4.199, J6.19
A15: J1.56, J1.200, J2.56, J2.200, J3.56, J3.200, J4.56, J4.200, J6.16
BEX082: J1.82, J1.226, J2.82, J2.226, J3.82, J3.226, J4.82, J4.226
BEX083: J1.83, J1.227, J2.83, J2.227, J3.83, J3.227, J4.83, J4.227
BEX084: J1.84, J1.228, J2.84, J2.228, J3.84, J3.228, J4.84, J4.228
BEX085: J1.85, J1.229, J2.85, J2.229, J3.85, J3.229, J4.85, J4.229
BEX086: J1.86, J1.230, J2.86, J2.230, J3.86, J3.230, J4.86, J4.230
BEX087: J1.87, J1.231, J2.87, J2.231, J3.87, J3.231, J4.87, J4.231
BEX088: J1.88, J1.232, J2.88, J2.232, J3.88, J3.232, J4.88, J4.232
BEX089: J1.89, J1.233, J2.89, J2.233, J3.89, J3.233, J4.89, J4.233
BEX094: J1.94, J1.238, J2.94, J2.238, J3.94, J3.238, J4.94, J4.238
BEX095: J1.95, J1.239, J2.95, J2.239, J3.95, J3.239, J4.95, J4.239
BEX096: J1.96, J1.240, J2.96, J2.240, J3.96, J3.240, J4.96, J4.240
BEX097: J1.97, J1.241, J2.97, J2.241, J3.97, J3.241, J4.97, J4.241
BEX098: J1.98, J1.242, J2.98, J2.242, J3.98, J3.242, J4.98, J4.242
BEX099: J1.99, J1.243, J2.99, J2.243, J3.99, J3.243, J4.99, J4.243
BEX100: J1.100, J1.244, J2.100, J2.244, J3.100, J3.244, J4.100, J4.244
BEX101: J1.101, J1.245, J2.101, J2.245, J3.101, J3.245, J4.101, J4.245
BEX106: J1.106, J1.250, J2.106, J2.250, J3.106, J3.250, J4.106, J4.250
BEX107: J1.107, J1.251, J2.107, J2.251, J3.107, J3.251, J4.107, J4.251
BEX108: J1.108, J1.252, J2.108, J2.252, J3.108, J3.252, J4.108, J4.252
BEX109: J1.109, J1.253, J2.109, J2.253, J3.109, J3.253, J4.109, J4.253
BEX110: J1.110, J1.254, J2.110, J2.254, J3.110, J3.254, J4.110, J4.254
BEX111: J1.111, J1.255, J2.111, J2.255, J3.111, J3.255, J4.111, J4.255
BEX112: J1.112, J1.256, J2.112, J2.256, J3.112, J3.256, J4.112, J4.256
BEX113: J1.113, J1.257, J2.113, J2.257, J3.113, J3.257, J4.113, J4.257
BEX118: J1.118, J1.262, J2.118, J2.262, J3.118, J3.262, J4.118, J4.262
BEX119: J1.119, J1.263, J2.119, J2.263, J3.119, J3.263, J4.119, J4.263
BEX120: J1.120, J1.264, J2.120, J2.264, J3.120, J3.264, J4.120, J4.264
BEX121: J1.121, J1.265, J2.121, J2.265, J3.121, J3.265, J4.121, J4.265
BEX122: J1.122, J1.266, J2.122, J2.266, J3.122, J3.266, J4.122, J4.266
BEX123: J1.123, J1.267, J2.123, J2.267, J3.123, J3.267, J4.123, J4.267
BEX124: J1.124, J1.268, J2.124, J2.268, J3.124, J3.268, J4.124, J4.268
BEX125: J1.125, J1.269, J2.125, J2.269, J3.125, J3.269, J4.125, J4.269
CLOCK: J1.12, J1.156, J2.12, J2.156, J3.12, J3.156, J4.12, J4.156, J6.51
D0: J1.17, J1.161, J2.17, J2.161, J3.17, J3.161, J4.17, J4.161, J6.69
D1: J1.18, J1.162, J2.18, J2.162, J3.18, J3.162, J4.18, J4.162, J6.70
D2: J1.19, J1.163, J2.19, J2.163, J3.19, J3.163, J4.19, J4.163, J6.75
D3: J1.20, J1.164, J2.20, J2.164, J3.20, J3.164, J4.20, J4.164, J6.77
D4: J1.21, J1.165, J2.21, J2.165, J3.21, J3.165, J4.21, J4.165, J6.35
D5: J1.22, J1.166, J2.22, J2.166, J3.22, J3.166, J4.22, J4.166, J6.37
D6: J1.23, J1.167, J2.23, J2.167, J3.23, J3.167, J4.23, J4.167, J6.47
D7: J1.24, J1.168, J2.24, J2.168, J3.24, J3.168, J4.24, J4.168, J6.48
DBIN: J1.11, J1.155, J2.11, J2.155, J3.11, J3.155, J4.11, J4.155, J6.52
GND: Cln_1.2, Cln_2.2, Cout_1.2, Cout_2.2, D1.2 (A), J1.3, J1.4, J1.15, J1.16, J1.27, J1.28, J1.39, J1.40, J1.51, J1.52, J1.63, J1.64, J1.75, J1.76, J1.80, J1.81, J1.92, J1.93, J1.104, J1.105, J1.116, J1.117, J1.128, J1.129, J1.140, J1.141, J1.147, J1.148, J1.159, J1.160, J1.171, J1.172, J1.183, J1.184, J1.195, J1.196, J1.207, J1.208, J1.219, J1.220, J1.224, J1.225, J1.236, J1.237, J1.248, J1.249, J1.260, J1.261, J1.272, J1.273, J1.284, J1.285, J1.SH1 (SHIELD), J1.SH2 (SHIELD__1), J1.SH3 (SHIELD__2), J2.3, J2.4, J2.15, J2.16, J2.27, J2.28, J2.39, J2.40, J2.51, J2.52, J2.63, J2.64, J2.75, J2.76, J2.80, J2.81, J2.92, J2.93, J2.104, J2.105, J2.116, J2.117, J2.128, J2.129, J2.140, J2.141, J2.147, J2.148, J2.159, J2.160, J2.171, J2.172, J2.183, J2.184, J2.195, J2.196, J2.207, J2.208, J2.219, J2.220, J2.224, J2.225, J2.236, J2.237, J2.248, J2.249, J2.260, J2.261, J2.272, J2.273, J2.284, J2.285, J2.SH1 (SHIELD), J2.SH2 (SHIELD__1), J2.SH3 (SHIELD__2), J3.3, J3.4, J3.15, J3.16, J3.27, J3.28, J3.39, J3.40, J3.51, J3.52, J3.63, J3.64, J3.75, J3.76, J3.80, J3.81, J3.92, J3.93, J3.104, J3.105, J3.116, J3.117, J3.128, J3.129, J3.140, J3.141, J3.147, J3.148, J3.159, J3.160, J3.171, J3.172, J3.183, J3.184, J3.195, J3.196, J3.207, J3.208, J3.219, J3.220, J3.224, J3.225, J3.236, J3.237, J3.248, J3.249, J3.260, J3.261, J3.272, J3.273, J3.284, J3.285, J3.SH1 (SHIELD), J3.SH2 (SHIELD__1), J3.SH3 (SHIELD__2), J4.3, J4.4, J4.15, J4.16, J4.27, J4.28, J4.39, J4.40, J4.51, J4.52, J4.63, J4.64, J4.75, J4.76, J4.80, J4.81, J4.92, J4.93, J4.104, J4.105, J4.116, J4.117, J4.128, J4.129, J4.140, J4.141, J4.147, J4.148, J4.159, J4.160, J4.171, J4.172, J4.183, J4.184, J4.195, J4.196, J4.207, J4.208, J4.219, J4.220, J4.224, J4.225, J4.236, J4.237, J4.248, J4.249, J4.260, J4.261, J4.272, J4.273, J4.284, J4.285, J4.SH1 (SHIELD), J4.SH2 (SHIELD__1), J4.SH3 (SHIELD__2), J5.A1_B12 (GND), J5.B1_A12 (GND__1), J5.SH1 (SHELL_GND), J5.SH2 (SHELL_GND__1), J5.SH3 (SHELL_GND__2), J5.SH4 (SHELL_GND__3), J6.3, J6.9, J6.15, J6.21, J6.27, J6.33, J6.39, J6.43, J6.49, J6.55, J6.61, J6.67, J6.73, J6.79, R1.2, R2.2, R4.2, R5.2, RBot1.2, U1.2 (GND)
HLDA: J1.48, J1.192, J2.48, J2.192, J3.48, J3.192, J4.48, J4.192, J6.28
HLTA: J1.65, J1.209, J2.65, J2.209, J3.65, J3.209, J4.65, J4.209, J6.13
INP: J1.60, J1.204, J2.60, J2.204, J3.60, J3.204, J4.60, J4.204, J6.17
INT: J1.68, J1.212, J2.68, J2.212, J3.68, J3.212, J4.68, J4.212, J6.6
INTA: J1.8, J1.152, J2.8, J2.152, J3.8, J3.152, J4.8, J4.152, J6.57
INTE: J1.44, J1.188, J2.44, J2.188, J3.44, J3.188, J4.44, J4.188, J6.30
M1: J1.58, J1.202, J2.58, J2.202, J3.58, J3.202, J4.58, J4.202, J6.22
MEMR: J1.59, J1.203, J2.59, J2.203, J3.59, J3.203, J4.59, J4.203, J6.18
MWRT: J1.10, J1.154, J2.10, J2.154, J3.10, J3.154, J4.10, J4.154, J6.53
unnamed: CB1.2, D1.1 (K), L1.1, U1.6 (SW)
unnamed: D2.1 (K), R5.1
unnamed: D4.1 (K), R4.1
unnamed: CB1.1, DB1.1 (K), U1.1 (BOOST)
unnamed: J5.A5 (CC1), R2.1
unnamed: J5.B5 (CC2), R1.1
unnamed: R3.1, RTop1.2
unnamed: RBot1.1, RTop1.1, U1.3 (V_{FB})
OUT: J1.57, J1.201, J2.57, J2.201, J3.57, J3.201, J4.57, J4.201, J6.23
PANEL: J1.9, J1.153, J2.9, J2.153, J3.9, J3.153, J4.9, J4.153, J6.54
PRDY: J1.6, J1.150, J2.6, J2.150, J3.6, J3.150, J4.6, J4.150, J6.59
PROT: J1.42, J1.186, J2.42, J2.186, J3.42, J3.186, J4.42, J4.186, J6.31
RESET: J1.5, J1.149, J2.5, J2.149, J3.5, J3.149, J4.5, J4.149, J6.60
STACK: J1.66, J1.210, J2.66, J2.210, J3.66, J3.210, J4.66, J4.210, J6.12
VBUS: D4.2 (A), J5.A4_B9 (VBUS), J5.B4_A9 (VBUS__1), S1.2
WAIT: J1.46, J1.190, J2.46, J2.190, J3.46, J3.190, J4.46, J4.190, J6.29
WO: J1.67, J1.211, J2.67, J2.211, J3.67, J3.211, J4.67, J4.211, J6.10
XRDY: J1.7, J1.151, J2.7, J2.151, J3.7, J3.151, J4.7, J4.151, J6.58

Notes on the sheet:
Buck Converter
FFC CONNECTOR
USB-C Port (Power)
DIMM SLOT 4
DIMM SLOT 3
SBU no connect
POWER FLAGS
DIMM SLOT 2
pull-down cannot be same part
POWER SWITCH
DIMM SLOT 1
