AlphaCassiopeiae/8800/ecad/backplane/backplane.kicad_pcb

## KiCad design ecad/backplane/backplane.kicad_pcb (continued)

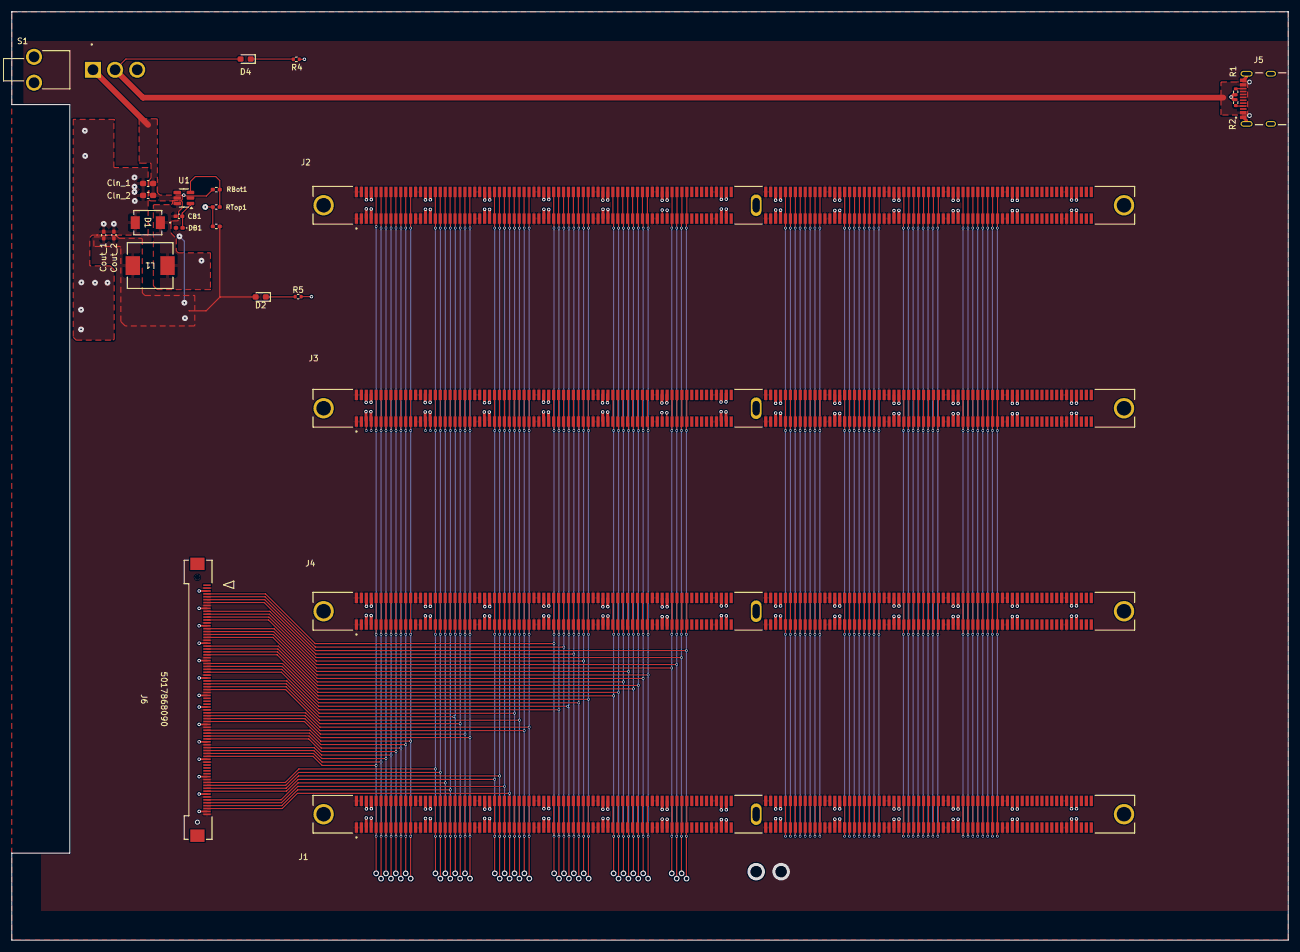
[picture p33: board backplane.kicad_pcb from above]

Board: 2 copper layers, 220.0 x 160.0 mm, 25 parts (0 on the bottom side), 88 nets.
