AlphaCassiopeiae/8800/rs/runner/src/runner.rs

// runner.rs - defines runner struct that will interact with tram
use common::*;
use crate::cpu::*;
use crate::instructions::*;

pub struct Runner {
    pub cpu: CPU,
    pub recv_channel: RX,
    pub send_channel: TX,
}

impl Runner {
    pub fn new(tx: TX, rx: RX) -> Self {
        Self {
            cpu: CPU::new(),
            recv_channel: rx,
            send_channel: tx,
        }
    }

    pub async fn send_msg(&self, message: Message) {
        self.send_channel.send(message).await;
    }

    pub async fn recv_msg(&self) -> Message {
        self.recv_channel.receive().await
    }
}
