AlphaCassiopeiae/8800/(commit log)

2025-01-27 Setup KiCAD project
    [ecad.kicad_pcb, ecad.kicad_sch]
2025-01-27 Changed EDA file
    [ecad.kicad_sch]
2025-01-29 Worked on Power PCB
    [Buck_Converter.kicad_sch, Front_Panel_sch.kicad_sch, ecad.kicad_pcb, ecad.kicad_sch, untitled.kicad_sch]
2025-01-29 To add front panel
    [Back_Panel_sch.kicad_sch, Buck_Converter.kicad_sch, Front_Panel_sch.kicad_sch, ecad.kicad_pcb, ecad.kicad_sch]
2025-01-31 Started Front Panel
    [Original Front.kicad_sch, ecad.kicad_sch]
2025-02-12 initial card schematic
    [ABM8-272-T3_ABR.step, Card.kicad_sch, ecad.kicad_sch]
2025-02-12 shit pico code that doesn't work
    [main.rs]
2025-02-19 lib additions
    [10145226-0241N13LF.step, Card.kicad_sch, ecad.kicad_sch]
2025-02-19 reorder pages
    [ecad.kicad_sch]
2025-02-24 Front Panel Schematic Done
    Finished Part of the Schematic, need to check for ERC.
    [Back_Plane.kicad_sch, Card_1.kicad_sch, Card_2.kicad_sch, Card_3.kicad_sch, Front_Panel.kicad_sch, Power_Converter.kicad_sch, Power_Distribution.kicad_sch]
2025-02-24 New Project Layout
    [Card_1.kicad_sch, Card_2.kicad_sch, Card_3.kicad_sch, Power_Distribution.kicad_sch, ecad.kicad_sch, references.kicad_sch]
2025-02-25 PCB Update
    [Back_Plane.kicad_sch, Card_1.kicad_sch, Card_2.kicad_sch, Card_3.kicad_sch, Front_Panel.kicad_sch, Power_Distribution.kicad_sch, ecad.kicad_pcb, ecad.kicad_sch]
2025-02-26 New labels
    [Card_3.kicad_sch, ecad.kicad_sch]
2025-02-26 Testing Resets Placed
    [Back_Plane.kicad_sch, Card_1.kicad_sch, Card_2.kicad_sch, Card_3.kicad_sch, Power_Distribution.kicad_sch, ecad.kicad_sch]
2025-02-26 new card boxes
    [Card_1.kicad_sch, ecad.kicad_sch]
2025-02-26 Front Panel Done, Time for ERC
    [ecad.kicad_sch]
2025-02-26 Ready for Layout
    [Back_Plane.kicad_sch, Card_1.kicad_sch, Power_Distribution.kicad_sch, ecad.kicad_pcb, ecad.kicad_sch]
2025-02-26 Back Plane Nearly Complete
    [Back_Plane.kicad_sch, Card_1.kicad_sch, ecad.kicad_sch]
2025-02-26 WOW CODE embassy
    [cmsis-dap.cfg, rp2350.cfg]
2025-02-26 Added 3 new project files
    [10145226-0241N13LF.step, ABM8-272-T3_ABR.step, Back_Panel_sch.kicad_sch, Back_Plane.kicad_sch, Buck_Converter.kicad_sch, Card.kicad_sch, Card_1.kicad_sch, Card_2.kicad_sch]
2025-02-26 New Component Library
    [front_panel.kicad_sch]
2025-02-27 Finished Library
    [Reverse LEDs (Red).step, front_panel.kicad_pcb]
2025-03-03 KiCAD 8.0 symbol and footprint library
    [Reverse LEDs (Red).step, back_plane (KiCad).kicad_pcb, back_plane (KiCad).kicad_sch, card.kicad_pcb, card.kicad_sch, card_template.kicad_pcb, card_template.kicad_sch, front_panel.kicad_pcb]
2025-03-04 Additional projects
    [backplane.kicad_pcb, backplane.kicad_sch, panel.kicad_pcb, panel.kicad_sch]
2025-03-04 pin libraries
2025-03-05 fixup card schematic new lib
    [card.kicad_sch]
2025-03-05 Realigned numbers
    [card.kicad_sch]
2025-03-05 boxed out card
    [card.kicad_sch]
2025-03-05 Added Connectors
    [panel.kicad_sch]
2025-03-05 fixup card labels
    [card.kicad_sch]
2025-03-05 integrate edge card symbol into card
    [card.kicad_sch]
2025-03-05 Finish Front Panel
    [panel.kicad_sch]
2025-03-05 card layout, lib updates
    [card.kicad_pcb, card.kicad_sch]
2025-03-05 initial card layout
    [card.kicad_pcb]
2025-03-05 fix zone priorities
    [card.kicad_pcb]
2025-03-05 finish backplane beta
    [backplane.kicad_pcb, backplane.kicad_sch]
2025-03-05 Front Panel Layout
    [panel.kicad_pcb, panel.kicad_sch, panel2.kicad_pcb, panel2.kicad_sch]
2025-03-10 PCB Changes
    [panel.kicad_pcb, panel.kicad_sch]
2025-03-10 Update PCB
    [panel.kicad_pcb, panel.kicad_sch]
2025-03-10 near-final card layout
    [card.kicad_pcb, card.kicad_sch]
2025-03-11 resolve some card DRC
    [card.kicad_pcb]
2025-03-11 card setup missing 3D
    [card.kicad_pcb]
2025-03-11 card add UART output, protection diode
    [card.kicad_pcb, card.kicad_sch]
2025-03-11 misc power via fixes
    [card.kicad_pcb]
2025-03-11 fixup unconnects card
    [card.kicad_pcb]
2025-03-12 smaller button
2025-03-12 various changes
    [1455T2201.stp, backplane.kicad_pcb, card.kicad_pcb, panel.kicad_pcb, panel.kicad_sch]
2025-03-12 more panel layout changes
    [panel.kicad_pcb, panel.kicad_sch]
2025-03-12 fix backplane pins
    [backplane.kicad_pcb, backplane.kicad_sch]
2025-03-12 Finished Card and Panel Schematics
    [card.kicad_pcb, card.kicad_sch, panel.kicad_sch]
2025-03-12 add back panel switch and tram outline
2025-03-13 more backplane. add nathan's panel changes
    [backplane.kicad_pcb, backplane.kicad_sch, panel.kicad_sch]
2025-03-13 remap changes, various card panel fixes
    [card.kicad_pcb, card.kicad_sch, panel.kicad_pcb, panel.kicad_sch]
2025-03-13 near-final panel routing
    [panel.kicad_pcb, panel.kicad_sch]
2025-03-13 minor panel adj.
    [panel.kicad_pcb, panel.kicad_sch]
2025-03-13 backplane with addr
    [backplane.kicad_pcb, backplane.kicad_sch]
2025-03-13 backplane with different bus names
    [backplane.kicad_sch]
2025-03-13 panel, routing, USB, switches, LDO
    [panel.kicad_pcb, panel.kicad_sch]
2025-03-14 panel silkscreen
    [panel.kicad_pcb]
2025-03-14 Back panel changes
    [backplane.kicad_sch, card.kicad_sch]
2025-03-14 add labels on card
    [card.kicad_pcb]
2025-03-14 more panel work
    [Silkscreen.dxf, panel.kicad_pcb, panel.kicad_sch]
2025-03-14 new diode, some panel pwr routing
    [card.kicad_sch, panel.kicad_pcb, panel.kicad_sch]
2025-03-14 Backplane changes
    [backplane.kicad_pcb, backplane.kicad_sch]
2025-03-14 Back Panel Done
    [backplane.kicad_pcb, backplane.kicad_sch]
2025-03-14 Panel final? route
    [panel.kicad_pcb, panel.kicad_sch]
2025-03-14 card connector, diode changes
    [card.kicad_pcb, card.kicad_sch]
2025-03-14 card silkscreen
    [card.kicad_pcb]
2025-03-14 general team number silkscreen
    [backplane.kicad_pcb, card.kicad_pcb, panel.kicad_pcb]
2025-03-14 rotate card UART 90
    [8800.FCStd, card.kicad_pcb]
2025-03-14 Gerber Files
2025-03-14 Card gerbers
    [card.kicad_pcb]
2025-03-14 Front panel gerbers
    [panel.kicad_pcb]
2025-03-14 add LCSC reverse LED
2025-03-14 BOM change
    [panel.kicad_sch]
2025-03-14 Panel Changes
    [panel.kicad_pcb, panel.kicad_sch]
2025-03-14 new LCSC library components
    [card.kicad_sch]
2025-03-14 Card BOM
    [card.kicad_sch]
2025-03-14 current production try
    [card.kicad_pcb, card.kicad_sch, panel.kicad_pcb, panel.kicad_sch]
2025-03-14 save panel
    [panel.kicad_pcb]
2025-03-14 clean up ecad die
    [10145226-0241N13LF.step, ABM8-272-T3_ABR.step, Back_Panel_sch.kicad_sch, Back_Plane.kicad_sch, Buck_Converter.kicad_sch, Card.kicad_sch, Card_1.kicad_sch, Card_2.kicad_sch]
2025-03-14 clean up ecad
    [panel2.kicad_pcb, panel2.kicad_sch]
2025-03-14 revisions after feedback
    [card.kicad_pcb, panel.kicad_pcb]
2025-03-14 fixup H excludes rules
    [panel.kicad_pcb]
2025-03-14 backplane add debug vias
    [backplane.kicad_pcb]
2025-03-15 various production cost changes
    [backplane.kicad_pcb, card.kicad_pcb, card.kicad_sch, panel.kicad_pcb, panel.kicad_sch]
2025-03-15 ecad no weird resistor group
    [card.kicad_pcb, card.kicad_sch, panel.kicad_pcb, panel.kicad_sch]
2025-03-15 I/O Changes
    [panel.kicad_sch]
2025-03-15 Swap GND (1) and 3.3V (3)
    [panel.kicad_sch]
2025-03-16 new panel routing
    [card.kicad_sch, panel.kicad_pcb, panel.kicad_sch]
2025-03-16 stackup changes, prodction
    [card.kicad_pcb, card.kicad_sch, panel.kicad_pcb, panel.kicad_sch]
2025-03-16 clean up backplane a bit
    [backplane.kicad_pcb]
2025-03-17 double up for HASL
    [backplane.kicad_pcb, backplane.kicad_sch, card.kicad_pcb, card.kicad_sch, panel.kicad_pcb, panel.kicad_sch]
2025-03-17 backplane reverse FFC wiring
    [backplane.kicad_pcb, backplane.kicad_sch]
2025-03-17 minor backplane revisions
    [backplane.kicad_pcb]
2025-03-17 change card HASL finish definition
    [card.kicad_pcb]
2025-03-17 add vishay LED symbol footprints for comparison
2025-03-17 fixup panel io expansion pinout
    [card.kicad_sch, panel.kicad_pcb, panel.kicad_sch]
2025-03-17 production fixups
    [card.kicad_pcb, card.kicad_sch, panel.kicad_pcb, panel.kicad_sch]
2025-03-17 additional production fixups
    [card.kicad_pcb, card.kicad_sch, panel.kicad_pcb, panel.kicad_sch]
2025-03-17 add Affinity file for silkscreen design
2025-03-18 Files for JLCPCB
    [8800.FCStd, backplane.kicad_pcb, card.kicad_pcb, card.kicad_sch, panel.kicad_pcb]
2025-03-19 increase via sizes
    [backplane.kicad_pcb, card.kicad_pcb, panel.kicad_pcb]
2025-03-19 minor routing adj.
    [panel.kicad_pcb]
2025-03-20 minor panel routing changes
    [panel.kicad_pcb]
2025-03-20 enlarge holes to 0.3mm
    [backplane.kicad_pcb, card.kicad_pcb, panel.kicad_pcb]
2025-03-26 cleaner tramsim framework
2025-04-07 trying to clean up framework
2025-04-09 runner framework
2025-04-09 vendor tcl rpi openocd
    [100ask-openjtag.cfg, 8devices-lima.cfg, actux3.cfg, adapteva_parallella1.cfg, adsp-sc584-ezbrd.cfg, advantech_imx8qm_dmsse20.cfg, alphascale_asm9260_ek.cfg, altera-10m50.cfg]
2025-04-09 tram all lcds, interchange i2c to leds, and update toolchain
    [cmsis-dap.cfg, rp2350.cfg]
2025-04-10 arm-none-eabi-gdb rpi openocd cortex-m toolchain
2025-04-11 Changes on remapping for archives
    [card.kicad_sch]
2025-04-15 fix rust analyzer complaints
    [hi2.rs, hm.rs]
2025-04-16 Laser Silkscreen
    [Laser_Cutout.FCStd, panel-User_9.dxf, panel.kicad_pcb]
2025-04-16 CAD Stuff IDK
    [#Laser.dxf, 8800.FCStd, Laser This.dxf]
2025-04-18 CAD Stuff
    [Back Bezel.dxf, Back Bezel.f3d, Front Bezel.dxf, Front Bezel.f3d, panel.kicad_pcb]
2025-04-22 CAD + Silkscreen Stuff
2025-04-23 KiCad + CAD
    [Black Bezel Fusion.f3z, Black Bezel.dwg, Blue Bezel Fusion.f3z, Blue Bezel.dwg]
2025-04-24 bus reads work on pin 34
2025-04-24 interchange buttons working
2025-04-25 reset works over bus
    [emu.rs, interchange.rs]
2025-04-25 no errors integration cpu memory
    [cpu.rs, emu.rs, ram.rs]
2025-04-30 examine and next buttons work
2025-04-30 poster assets
    [8800.FCStd, Back Bezel Cutout.step, Front Bezel Cutout.step]
